dannyandreev/BOM-Lights/Guide/Step 1.png

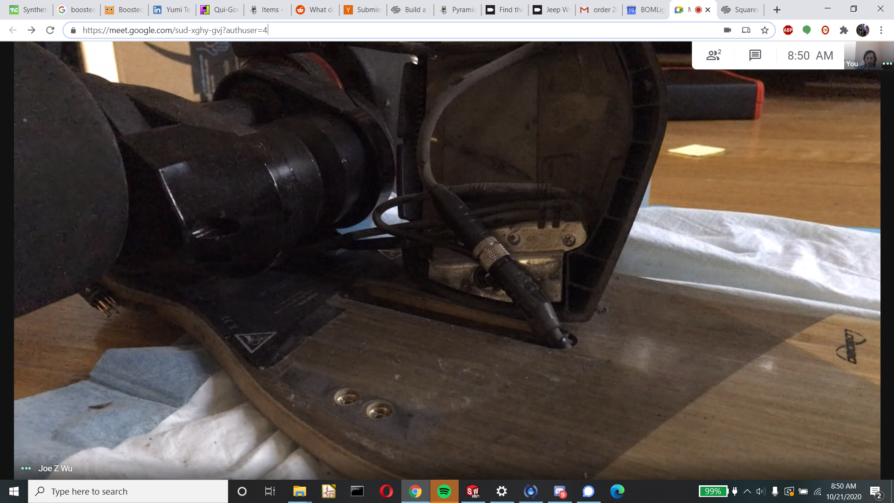
Guide/Step 1.png
