dannyandreev/BOM-Lights/Guide/Step 2.png

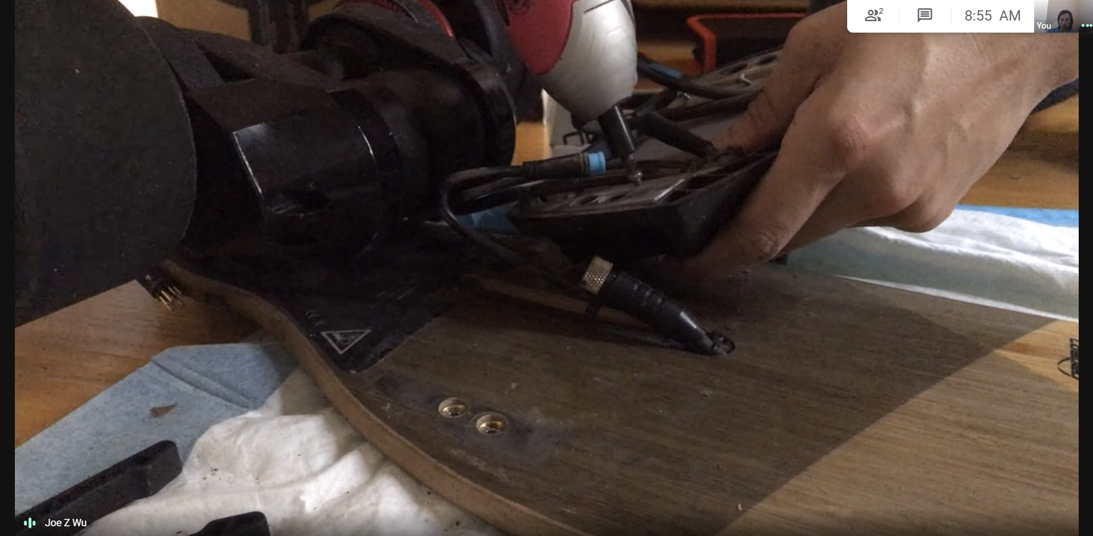
Guide/Step 2.png
