dannyandreev/BOM-Lights/Hardware/Packaging/BOX Text.jpg

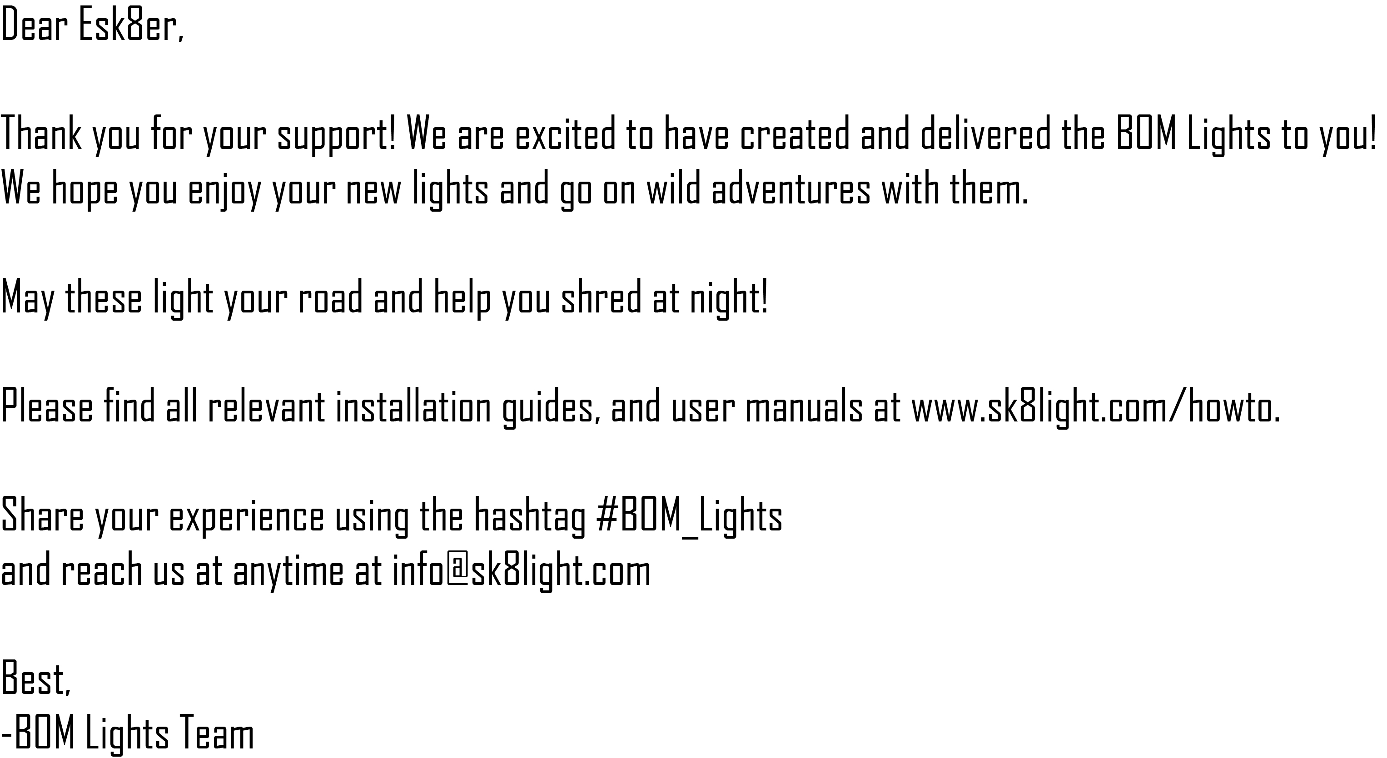
Hardware/Packaging/BOX Text.jpg
