dannyandreev/BOM-Lights/Electrical/SkateLightLEDBoard/SkateLightLEDBoard1.4/SkateLightLEDBoard1.4_BOM/SkateLightLEDBoard.csv

Id | Designator | Package | Quantity | Designation | Supplier and ref
1 | D3,D4,D5 | BXRE-40E0800-D-73 | 3 | LED
2 | J2,J1 | Conn_2x4_0.05in | 2 | Conn_02x04_Odd_Even
3 | H8,H7,H6,H5,H1,H2,H3,H4 | MH_0-80_Screw_Grounded | 8 | MountingHole_Pad
4 | U1,U2 | SOT-23 | 2 | MCP9700AT-E_TT
5 | D1 | D_0402_1005Metric | 1 | LEDR
6 | D2 | D_0402_1005Metric | 1 | LEDG
7 | Q1,Q2 | D_0603_1608Metric | 2 | Q_Photo_NPN
8 | R3,R4 | R_0402_1005Metric | 2 | 10k 1%
9 | R1 | R_0402_1005Metric | 1 | 2k7 5%
10 | R2 | R_0402_1005Metric | 1 | 390 5%
