dannyandreev/BOM-Lights/Electrical/SkateLightLEDBoard/SkateLightLEDBoard1.5/SkateLightLEDBoard1.5_BOM/SkateLightLEDBoard1.5_BOM.xls

Id | Designator | Package | Designation | Supplier and ref | Quantity
1 | D3,D4,D5 | BXRE-40E0800-D-73 | LED | BXRE-40E0800-D-73 (https://www.digikey.com/product-detail/en/BXRE-40E0800-D-73/976-1718-ND/7491539/?itemSeq=329745206) | 3
2 | J2,J1 | Conn_2x4_0.05in | Conn_02x04_Odd_Even | 20021111-00008T4LF (https://www.digikey.com/product-detail/en/amphenol-icc-fci/20021111-00008T4LF/609-3711-ND/2209071) | 2
3 | H8,H7,H6,H5,H1,H2,H3,H4 | MH_0-80_Screw_Grounded | MountingHole_Pad | Not Populated | 0
4 | U1,U2 | SOT-23 | MCP9700AT-E_TT | MCP9700AT-E/TT (https://www.digikey.com/product-detail/en/microchip-technology/MCP9700AT-E-TT/MCP9700AT-E-TTCT-ND/3622388) | 2
5 | D1 | D_0402_1005Metric | LEDR | QBLP595-R (https://www.digikey.com/product-detail/en/qt-brightek-qtb/QBLP595-R/1516-1217-1-ND/6201914) | 1
6 | D2 | D_0402_1005Metric | LEDG | QBLP595-IG (https://www.digikey.com/product-detail/en/qt-brightek-qtb/QBLP595-IG/1516-1216-1-ND/6201913) | 1
7 | Q1,Q2 | D_0603_1608Metric | Q_Photo_NPN | PT19-21B/L41/TR8 (https://www.digikey.com/product-detail/en/everlight-electronics-co-ltd/PT19-21B-L41-TR8/1080-1383-1-ND/2676117) | 2
8 | R3,R4 | R_0402_1005Metric | 100k 1% | RMCF0402FT100K (https://www.digikey.com/product-detail/en/stackpole-electronics-inc/RMCF0402FT100K/RMCF0402FT100KCT-ND/1942928) | 2
9 | R1,R2 | R_0402_1005Metric | 2k7 5% | ERJ-2RKF2701X (https://www.digikey.com/product-detail/en/panasonic-electronic-components/ERJ-2RKF2701X/P2-70KLCT-ND/1746662) | 1
