dannyandreev/BOM-Lights/Electrical/SkateLightConnBoard/SkateLightConnBoard1.3/SkateLightConnBoard1.3_BOM/SkateLightConnBoard.csv

Id | Designator | Package | Designation | Supplier and ref | Quantity
1 | J3,J1 | Conn_2x4_0.05in | Conn_02x04_Odd_Even | 20021311-00008T4LF | 2
2 | J2 | Conn_2x8_0.05in | Conn_02x08_Odd_Even | 20021112-00016T4LF | 1
