dannyandreev/BOM-Lights/Hardware/SkateLightV3.7 7-11-20/SkatelightV3.7.SLDASM

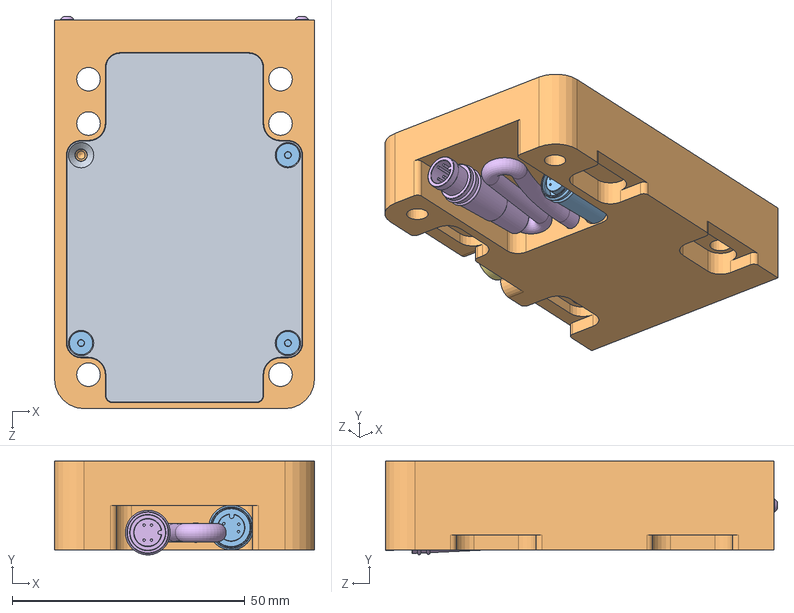
[picture p4: CAD file, 2022-03-13]
Hardware/SkateLightV3.7 7-11-20/SkatelightV3.7.SLDASM
55.9 x 20.1 x 84.3 mm
SkatelightBodyV5.8
SkateLightLEDBoard1.3
BXRE-40E0800-D-73 x 3
92949A050_18-8 SS BUTTON HEAD HEX DRIVE SCREW x 4
92949A054_18-8 SS BUTTON HEAD HEX DRIVE SCREW x 6
Header.05 Pitch Male 8Pin 2Row 2.54mm x 2
Header.05 Pitch Female 8Pin 2Row 20021311-00008T4LF x 4
Header.05 Pitch Male Right Angle 16Pin 2Row FTSH-108-01-L-D-RA x 2
SkatelightConnectorBoard1.2 x 2
92210A077_18-8 STAINLESS STEEL FLAT-HEAD SCKT CAP SCREW x 3
VSON-8_3.3x3.3mm_P0.65mm_NexFET x 2
MS-026ABA
LGA-14_3x2.5mm_P0.5mm_LayoutBorder3x4y
C1210_270
7447709151 Inductor
ETQ-P5M101YGC Inductor
92949A077_18-8 SS BUTTON HEAD HEX DRIVE SCREW x 2
SkatelightLidV5.7
SkatelightLEDCapV5.1
Lid gasket
LED gasket
Julet Gen 1 4 Pin M TailCustom
Acouto 1A 24V 8mm Mini Switch
Julet Gen 1 4 Pin F TailCustom
PiezoBuzzer
