dannyandreev/BOM-Lights/Hardware/V3/SkateLightLEDBackPanelAssembly.SLDASM

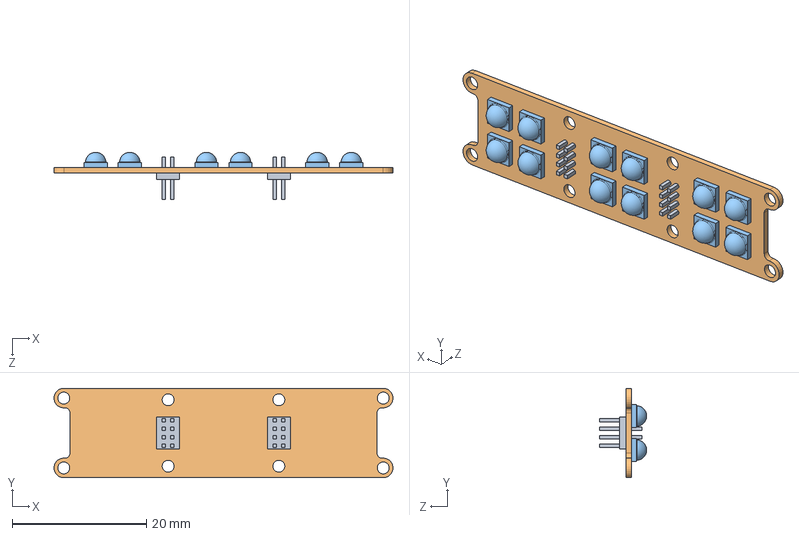
[picture p5: CAD file, 2022-03-13]
Hardware/V3/SkateLightLEDBackPanelAssembly.SLDASM
50.5 x 13.3 x 7.06 mm
Header.05 Pitch Male 8Pin 2Row 1mm HPH2-A-08-UA x 2
LEDBackPanel
XLampXPE2 x 12
