dannyandreev/BOM-Lights/Hardware/SkateLightV3.7 7-11-20/SkateLightMainBoard3.2.SLDASM

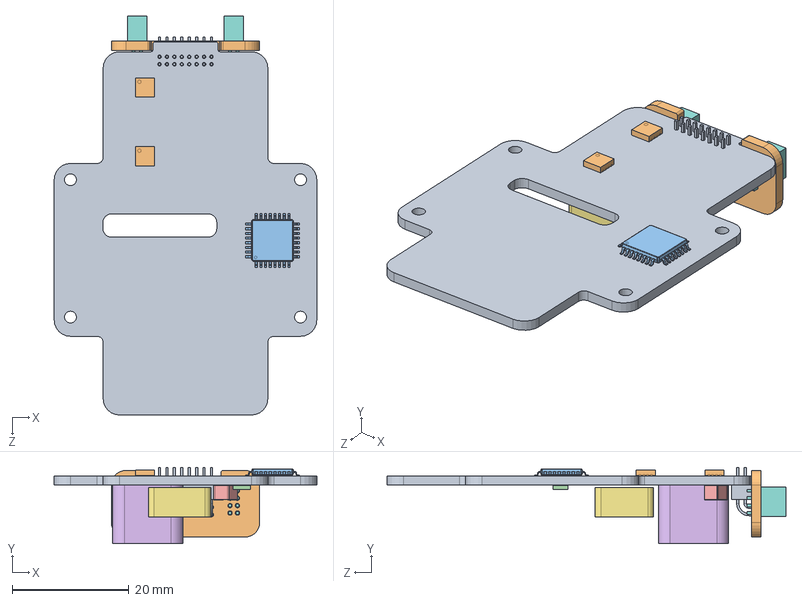
[picture p6: CAD file, 2022-03-13]
Hardware/SkateLightV3.7 7-11-20/SkateLightMainBoard3.2.SLDASM
45.0 x 13.0 x 68.3 mm
SkatelightMainBoard3.2
VSON-8_3.3x3.3mm_P0.65mm_NexFET x 2
MS-026ABA
LGA-14_3x2.5mm_P0.5mm_LayoutBorder3x4y
C1210_270
7447709151 Inductor
ETQ-P5M101YGC Inductor
Header.05 Pitch Female 8Pin 2Row 20021311-00008T4LF x 2
Header.05 Pitch Male Right Angle 16Pin 2Row FTSH-108-01-L-D-RA
SkatelightConnectorBoard1.2
