dannyandreev/BOM-Lights/Hardware/Packaging/PackageWithBox.SLDASM

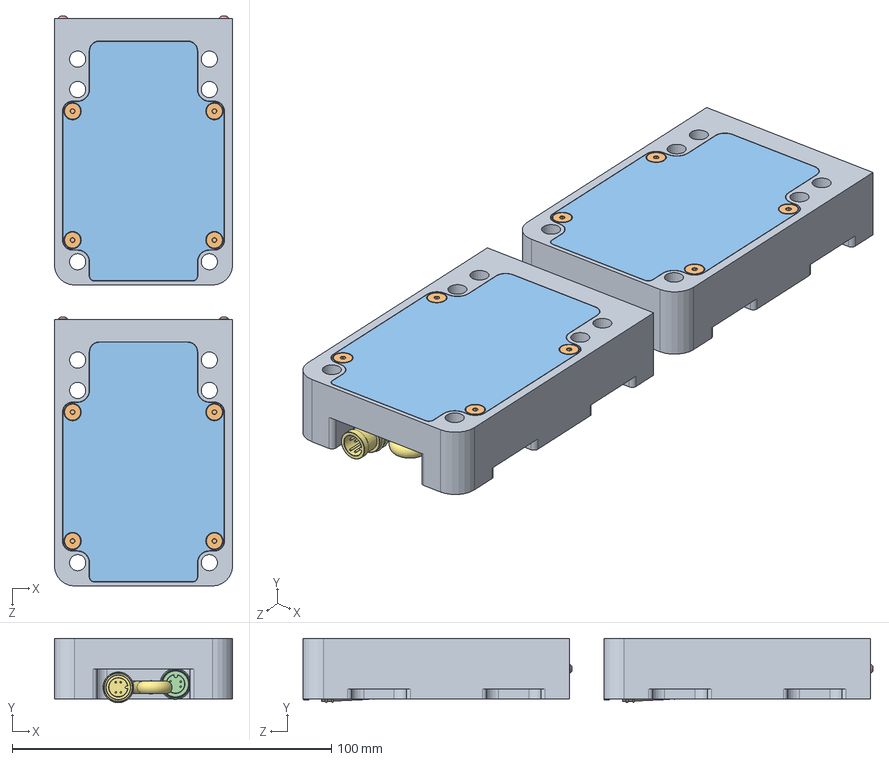
[picture p7: CAD file, 2022-03-13]
Hardware/Packaging/PackageWithBox.SLDASM
55.9 x 20.1 x 178.6 mm
SkatelightBodyV5.8 x 2
SkateLightLEDBoard1.3 x 2
BXRE-40E0800-D-73 x 6
92949A050_18-8 SS BUTTON HEAD HEX DRIVE SCREW x 8
92949A054_18-8 SS BUTTON HEAD HEX DRIVE SCREW x 12
Header.05 Pitch Male 8Pin 2Row 2.54mm x 4
Header.05 Pitch Female 8Pin 2Row 20021311-00008T4LF x 8
Header.05 Pitch Male Right Angle 16Pin 2Row FTSH-108-01-L-D-RA x 4
SkatelightConnectorBoard1.2 x 4
92210A077_18-8 STAINLESS STEEL FLAT-HEAD SCKT CAP SCREW x 8
SkatelightMainBoard3.2 x 2
VSON-8_3.3x3.3mm_P0.65mm_NexFET x 4
MS-026ABA x 2
LGA-14_3x2.5mm_P0.5mm_LayoutBorder3x4y x 2
C1210_270 x 2
7447709151 Inductor x 2
ETQ-P5M101YGC Inductor x 2
92949A077_18-8 SS BUTTON HEAD HEX DRIVE SCREW x 8
SkatelightLidV5.7 x 2
SkatelightLEDCapV5.1 x 2
Lid gasket x 2
LED gasket x 2
Julet Gen 1 4 Pin M TailCustom x 2
Acouto 1A 24V 8mm Mini Switch x 2
Julet Gen 1 4 Pin F TailCustom x 2
PiezoBuzzer x 2
