dannyandreev/BOM-Lights/Hardware/SkateLightV3.6 6-10-20/LEDPanelAssembly.SLDASM

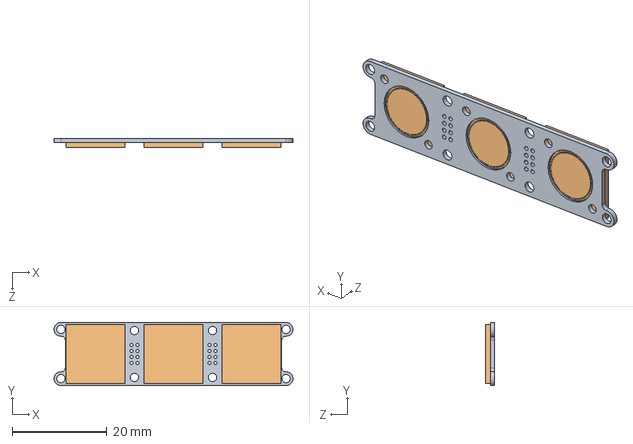
[picture p8: CAD file, 2022-03-13]
Hardware/SkateLightV3.6 6-10-20/LEDPanelAssembly.SLDASM
50.5 x 13.3 x 1.80 mm
SkateLightLEDBoard1.3
BXRE-40E0800-D-73 x 3
