dannyandreev/BOM-Lights/Hardware/SkateLightV3.6 6-10-20/ConnAssembly.SLDASM

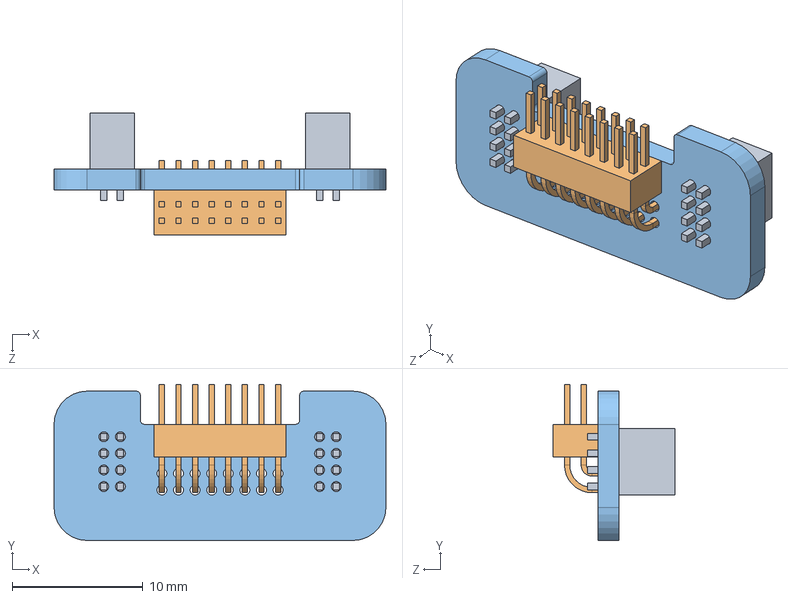
[picture p9: CAD file, 2022-03-13]
Hardware/SkateLightV3.6 6-10-20/ConnAssembly.SLDASM
25.4 x 11.9 x 9.33 mm
Header.05 Pitch Female 8Pin 2Row 20021311-00008T4LF x 2
Header.05 Pitch Male Right Angle 16Pin 2Row FTSH-108-01-L-D-RA
SkatelightConnectorBoard1.2
