dannyandreev/BOM-Lights/Hardware/SkateLightV3.6 6-10-20/SkateLightMainBoard3.1.SLDASM

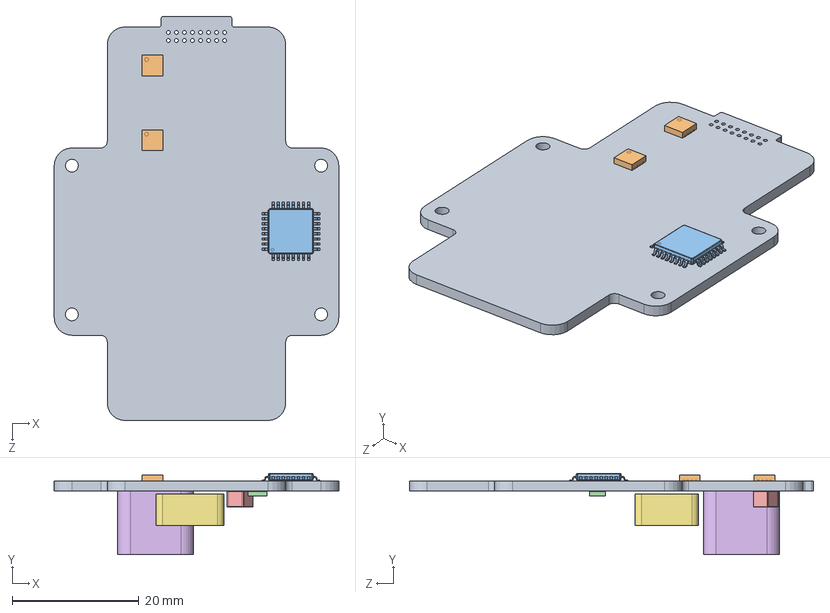
[picture p10: CAD file, 2022-03-13]
Hardware/SkateLightV3.6 6-10-20/SkateLightMainBoard3.1.SLDASM
45.0 x 12.8 x 63.8 mm
SkatelightMainBoard3.2
VSON-8_3.3x3.3mm_P0.65mm_NexFET x 2
MS-026ABA
LGA-14_3x2.5mm_P0.5mm_LayoutBorder3x4y
C1210_270
7447709151 Inductor
ETQ-P5M101YGC Inductor
