dannyandreev/BOM-Lights/Hardware/SkateLightV3.6 6-10-20/SkatelightV3.6.SLDASM

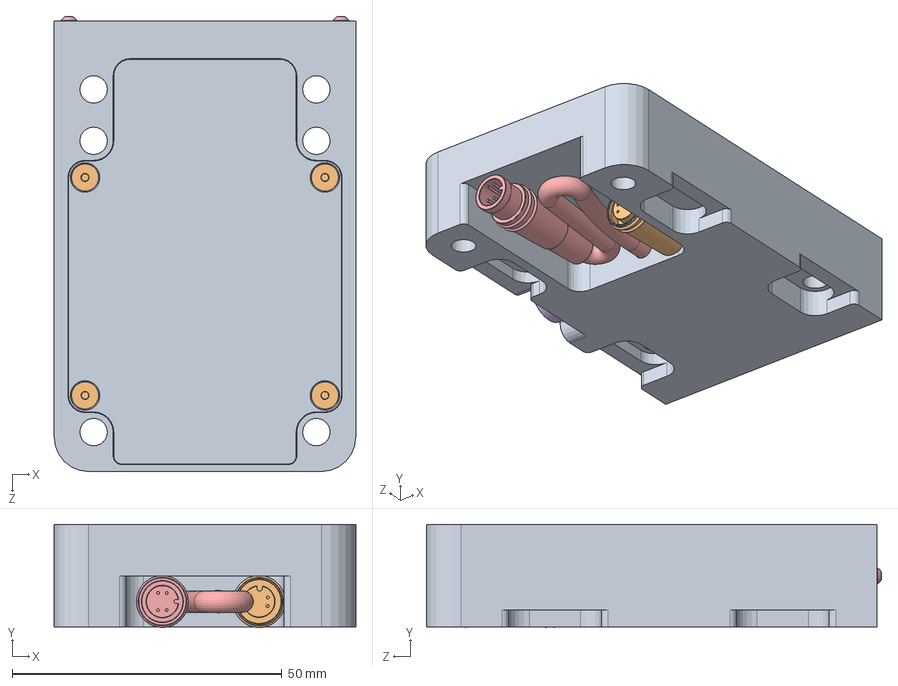
[picture p11: CAD file, 2022-03-13]
Hardware/SkateLightV3.6 6-10-20/SkatelightV3.6.SLDASM
55.9 x 19.1 x 84.3 mm
SkatelightBodyV5.8
SkateLightLEDBoard1.3
BXRE-40E0800-D-73 x 3
92949A050_18-8 SS BUTTON HEAD HEX DRIVE SCREW x 4
92949A054_18-8 SS BUTTON HEAD HEX DRIVE SCREW x 6
Header.05 Pitch Male 8Pin 2Row 2.54mm x 2
Header.05 Pitch Female 8Pin 2Row 20021311-00008T4LF x 2
Header.05 Pitch Male Right Angle 16Pin 2Row FTSH-108-01-L-D-RA
SkatelightConnectorBoard1.2
92210A077_18-8 STAINLESS STEEL FLAT-HEAD SCKT CAP SCREW x 4
VSON-8_3.3x3.3mm_P0.65mm_NexFET x 2
MS-026ABA
LGA-14_3x2.5mm_P0.5mm_LayoutBorder3x4y
C1210_270
ETQ-P5M101YGC Inductor
92949A077_18-8 SS BUTTON HEAD HEX DRIVE SCREW x 4
SkatelightLidV5.7
SkatelightLEDCapV5
Lid gasket
LED gasket
Julet Gen 1 4 Pin M TailCustom
Acouto 1A 24V 8mm Mini Switch
Julet Gen 1 4 Pin F TailCustom
