dannyandreev/BOM-Lights/Hardware/Compatability/Boosted Truck Black.SLDPRT

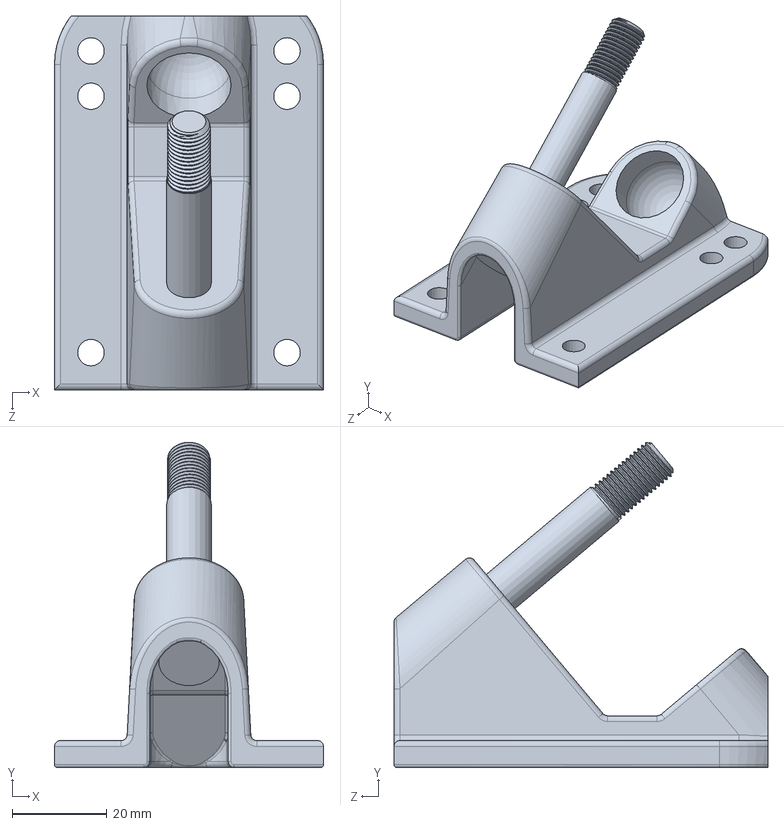
[picture p12: CAD file, 2022-03-13]
Hardware/Compatability/Boosted Truck Black.SLDPRT
56.6 x 68.5 x 78.7 mm
