dannyandreev/BOM-Lights/Hardware/Packaging/FoamInsert.SLDPRT

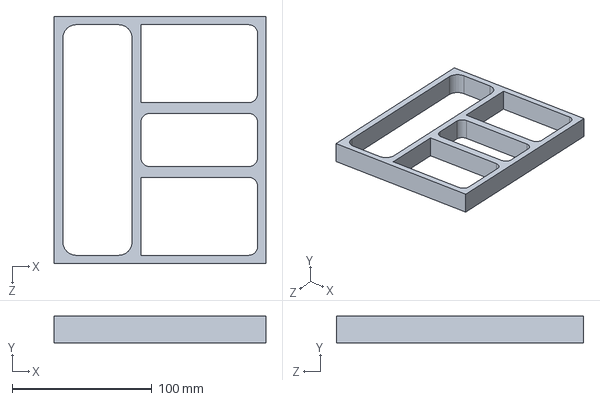
[picture p13: CAD file, 2022-03-13]
Hardware/Packaging/FoamInsert.SLDPRT
151.8 x 19.0 x 177.2 mm
