dannyandreev/BOM-Lights/Hardware/SkateLightV3.6 6-10-20/Lid gasket.SLDPRT

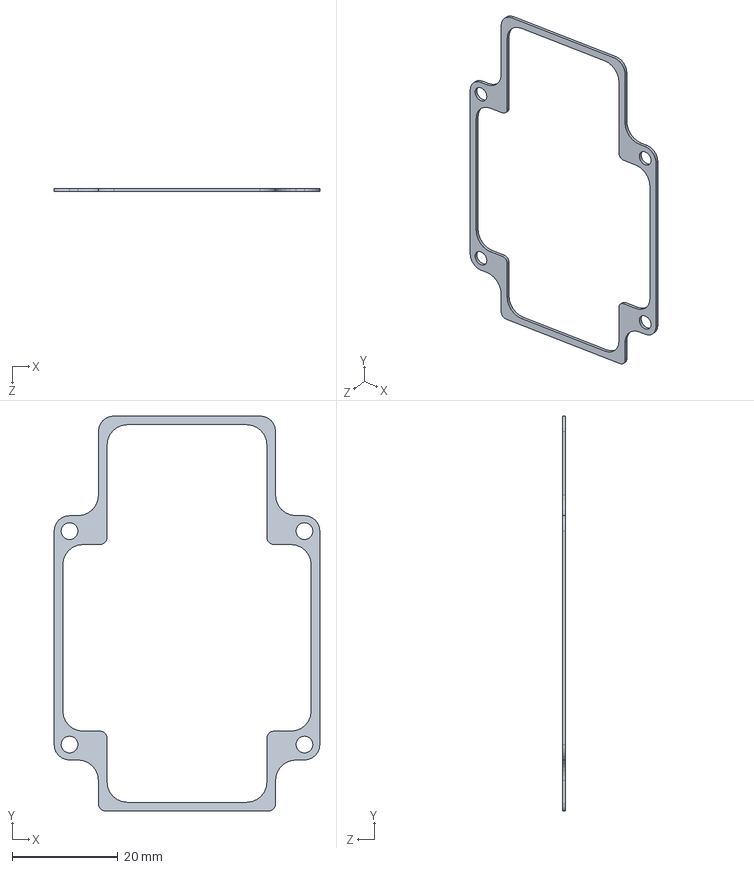
[picture p14: CAD file, 2022-03-13]
Hardware/SkateLightV3.6 6-10-20/Lid gasket.SLDPRT
50.3 x 74.7 x 0.65 mm
