dannyandreev/BOM-Lights/Hardware/Compatability/BoostedDeck.SLDPRT

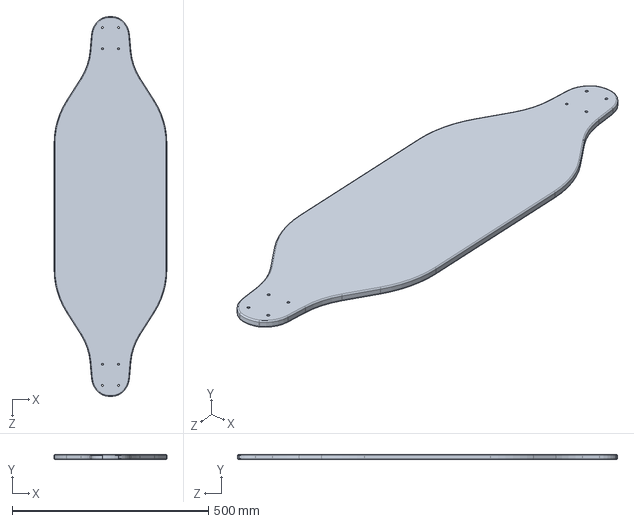
[picture p15: CAD file, 2022-03-13]
Hardware/Compatability/BoostedDeck.SLDPRT
287.0 x 12.7 x 967.5 mm
