dannyandreev/BOM-Lights/Hardware/Packaging/Box_1inx6inx7in.SLDPRT

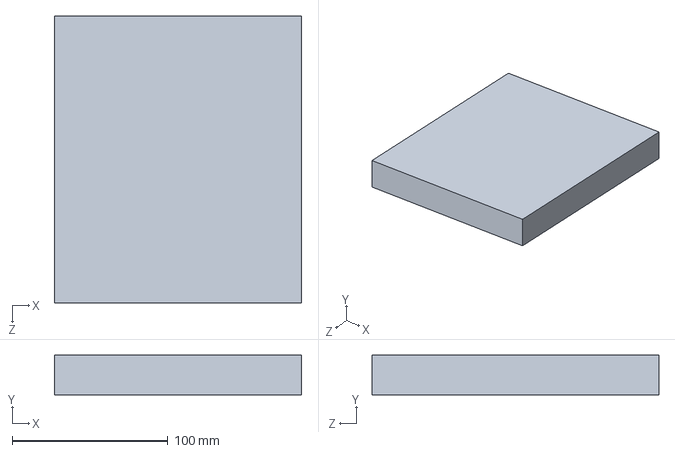
[picture p16: CAD file, 2022-03-13]
Hardware/Packaging/Box_1inx6inx7in.SLDPRT
158.8 x 25.4 x 184.1 mm
