dannyandreev/BOM-Lights/Hardware/SkateLightV3.6 6-10-20/SkatelightConnectorBoard1.2.SLDPRT

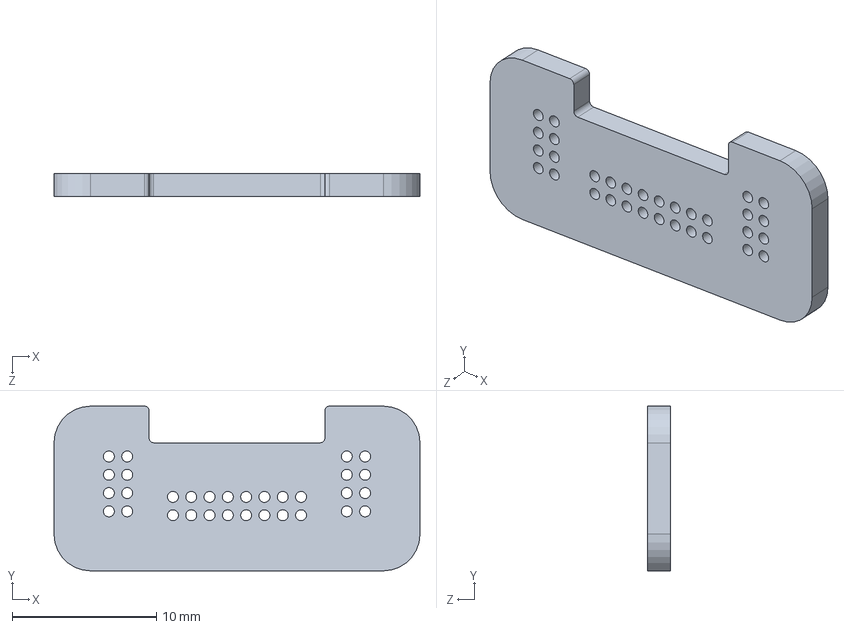
[picture p17: CAD file, 2022-03-13]
Hardware/SkateLightV3.6 6-10-20/SkatelightConnectorBoard1.2.SLDPRT
25.4 x 11.4 x 1.60 mm
