dannyandreev/BOM-Lights/Hardware/V3/SkateLightLEDBoard1.3.SLDPRT

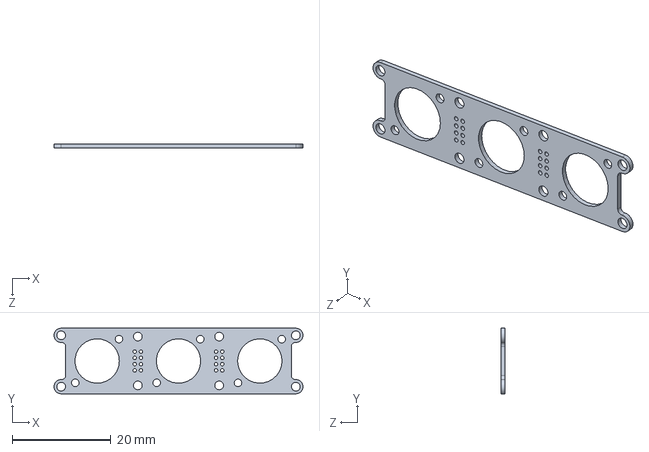
[picture p18: CAD file, 2022-03-13]
Hardware/V3/SkateLightLEDBoard1.3.SLDPRT
50.5 x 13.3 x 0.8 mm
