dannyandreev/BOM-Lights/Hardware/Compatability/Riser.SLDPRT

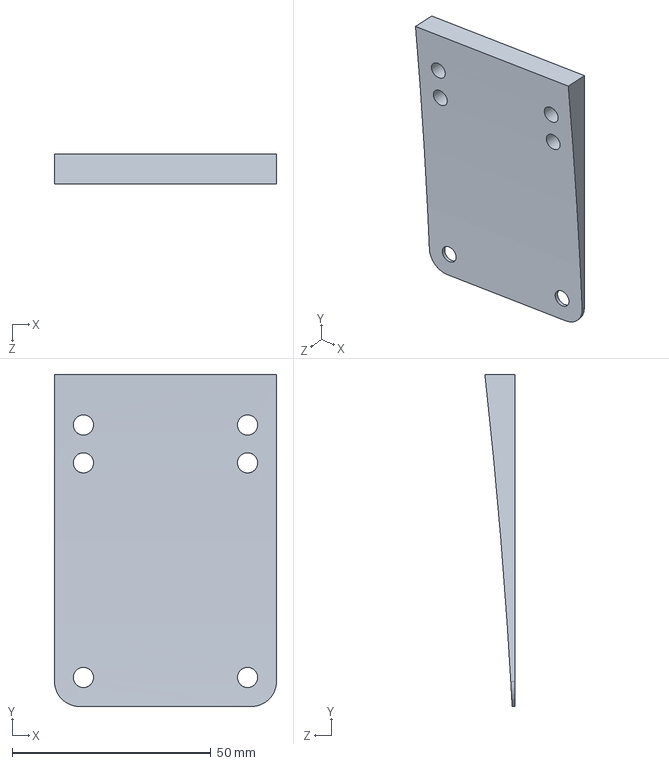
[picture p19: CAD file, 2022-03-13]
Hardware/Compatability/Riser.SLDPRT
55.9 x 83.5 x 7.62 mm
