dannyandreev/BOM-Lights/Hardware/SkateLightV3.7 7-11-20/SkatelightLEDCapV5.1.SLDPRT

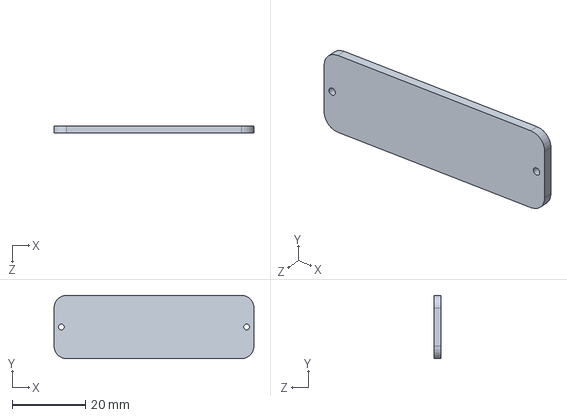
[picture p20: CAD file, 2022-03-13]
Hardware/SkateLightV3.7 7-11-20/SkatelightLEDCapV5.1.SLDPRT
54.5 x 17.3 x 2.00 mm
