dannyandreev/BOM-Lights/Hardware/V3/Header.05 Pitch Female 8Pin 2Row 20021311-00008T4LF.SLDPRT

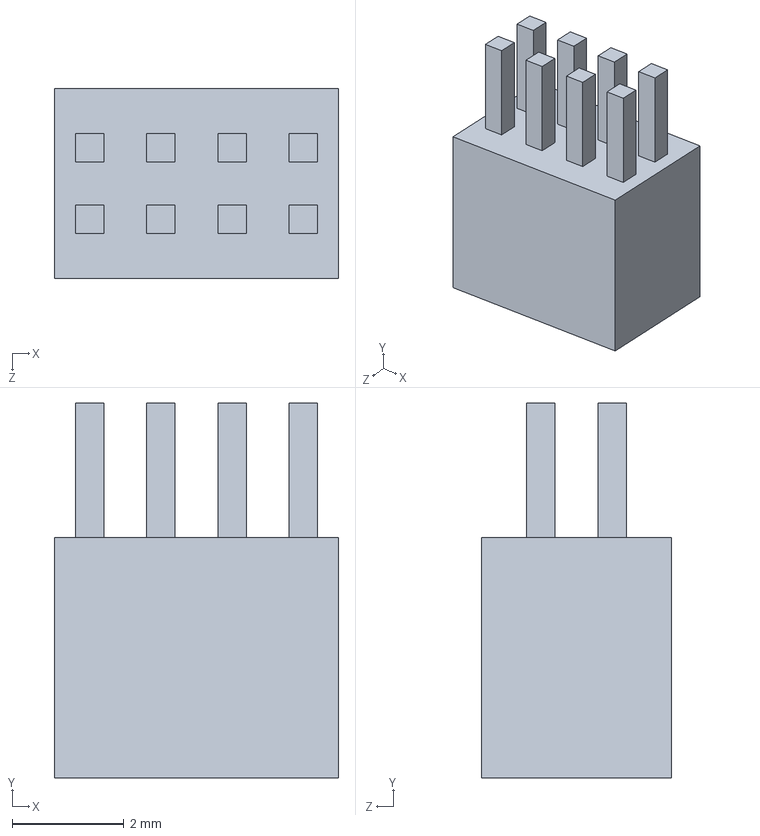
[picture p21: CAD file, 2022-03-13]
Hardware/V3/Header.05 Pitch Female 8Pin 2Row 20021311-00008T4LF.SLDPRT
5.08 x 6.70 x 3.40 mm
