dannyandreev/BOM-Lights/Hardware/Compatability/JL-F-Z910AT.SLDPRT

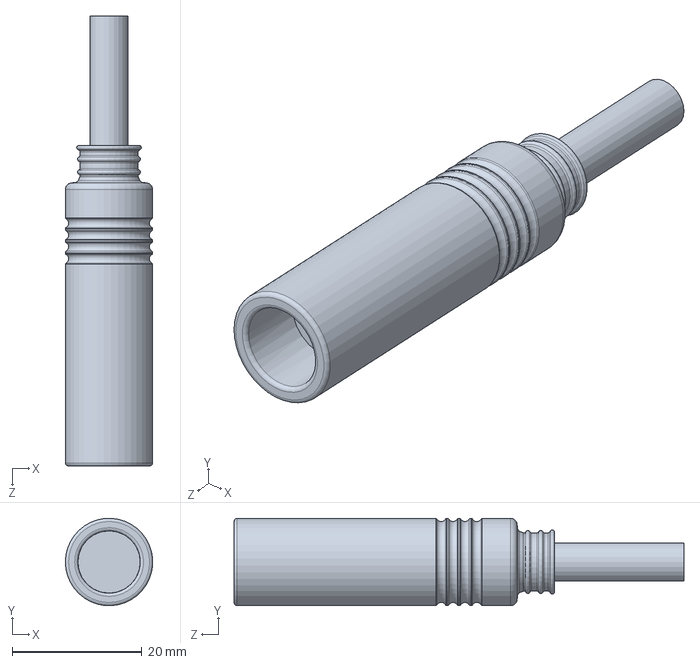
[picture p22: CAD file, 2022-03-13]
Hardware/Compatability/JL-F-Z910AT.SLDPRT
13.5 x 13.5 x 69.5 mm
