dannyandreev/BOM-Lights/Hardware/SkateLightV3.6 6-10-20/Julet Gen 1 4 Pin F TailCustom.SLDPRT

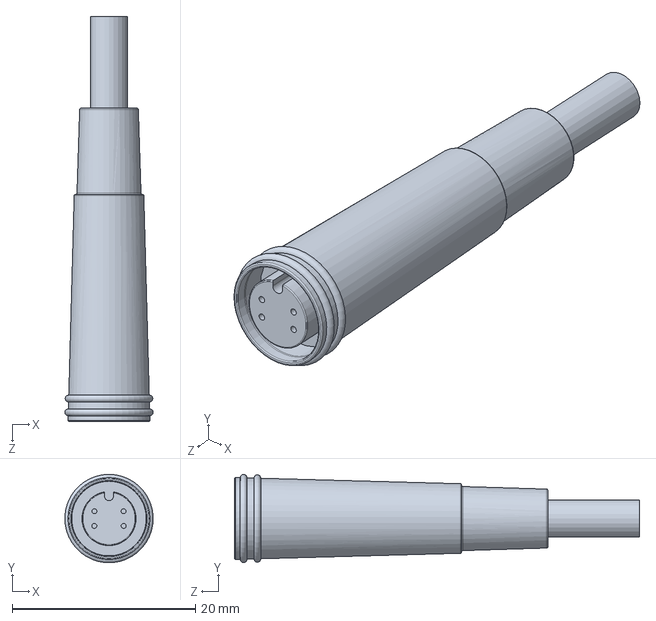
[picture p23: CAD file, 2022-03-13]
Hardware/SkateLightV3.6 6-10-20/Julet Gen 1 4 Pin F TailCustom.SLDPRT
9.65 x 9.64 x 44.2 mm
