dannyandreev/BOM-Lights/Hardware/SkateLightV3.7 7-11-20/SkatelightBodyV5.8.SLDPRT

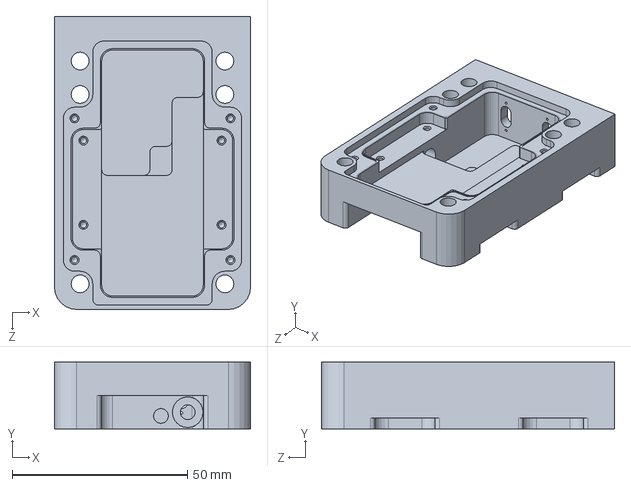
[picture p24: CAD file, 2022-03-13]
Hardware/SkateLightV3.7 7-11-20/SkatelightBodyV5.8.SLDPRT
55.9 x 19.1 x 83.5 mm
