dannyandreev/BOM-Lights/Hardware/V3/LEDBackPanel.SLDPRT

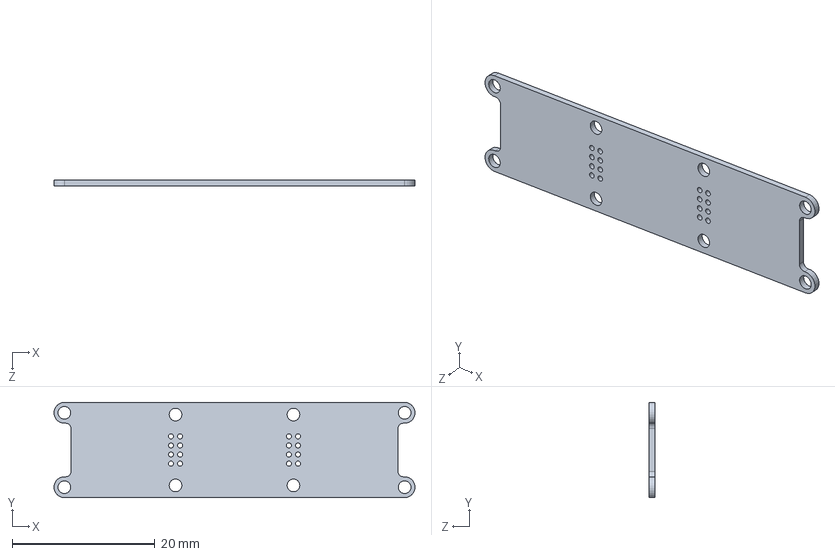
[picture p25: CAD file, 2022-03-13]
Hardware/V3/LEDBackPanel.SLDPRT
50.5 x 13.3 x 0.8 mm
