dannyandreev/BOM-Lights/Hardware/Compatability/BoostedPortWire.SLDPRT

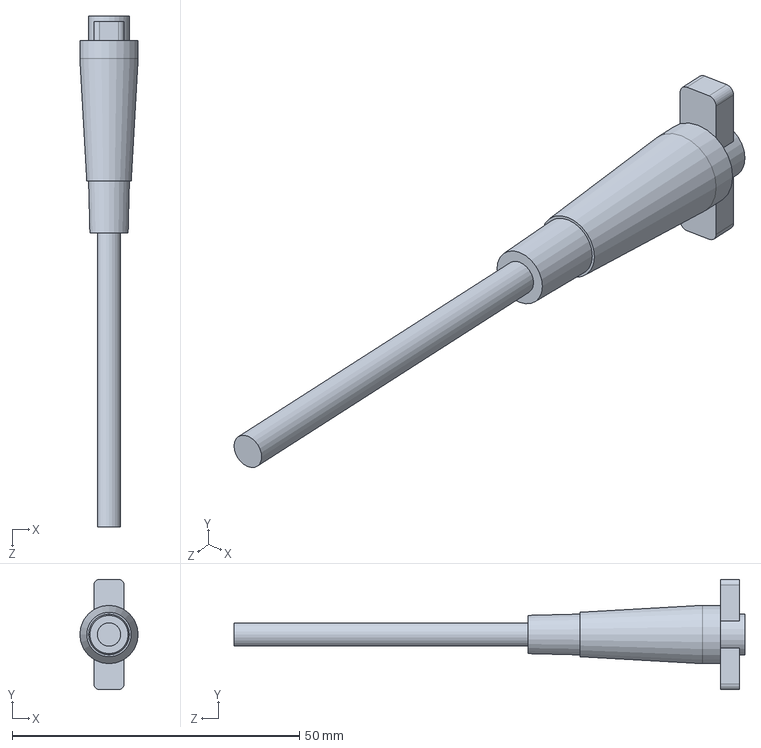
[picture p26: CAD file, 2022-03-13]
Hardware/Compatability/BoostedPortWire.SLDPRT
10.2 x 19.2 x 88.9 mm
