dannyandreev/BOM-Lights/Hardware/SkateLightV3.7 7-11-20/PiezoBuzzer.SLDPRT

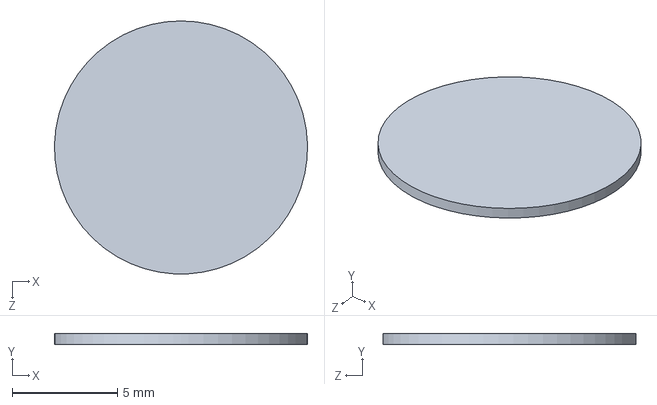
[picture p27: CAD file, 2022-03-13]
Hardware/SkateLightV3.7 7-11-20/PiezoBuzzer.SLDPRT
12.0 x 0.508 x 12.0 mm
