dannyandreev/BOM-Lights/Hardware/V3/Header.05 Pitch Male Right Angle 16Pin 2Row FTSH-108-01-L-D-RA.SLDPRT

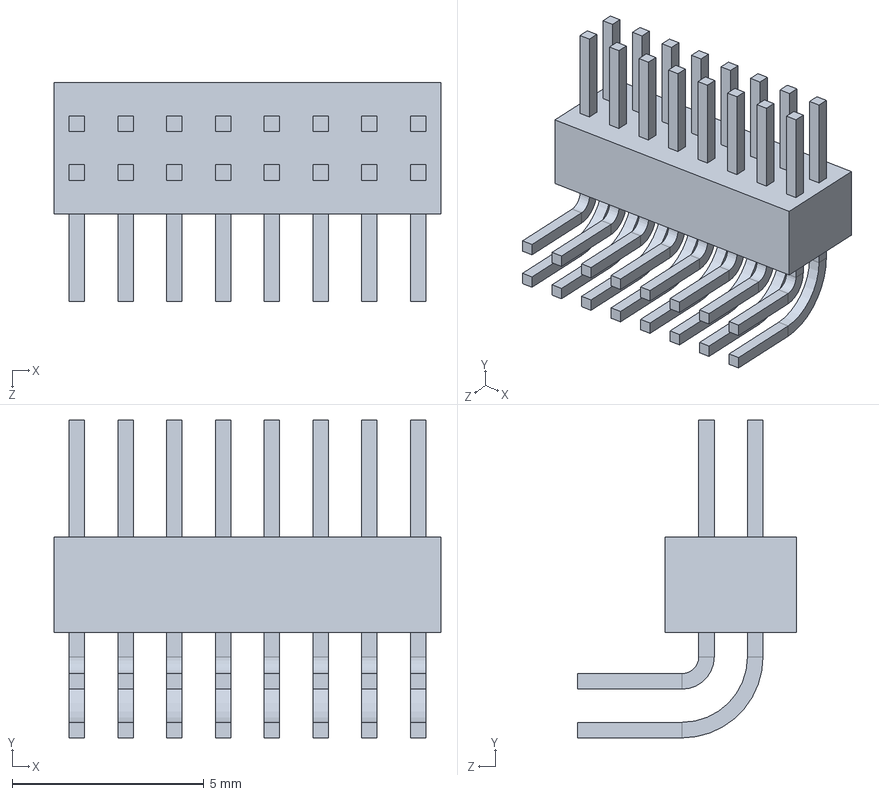
[picture p28: CAD file, 2022-03-13]
Hardware/V3/Header.05 Pitch Male Right Angle 16Pin 2Row FTSH-108-01-L-D-RA.SLDPRT
10.1 x 8.28 x 5.71 mm
