dannyandreev/BOM-Lights/Hardware/Compatability/MotorWireClipR.SLDPRT

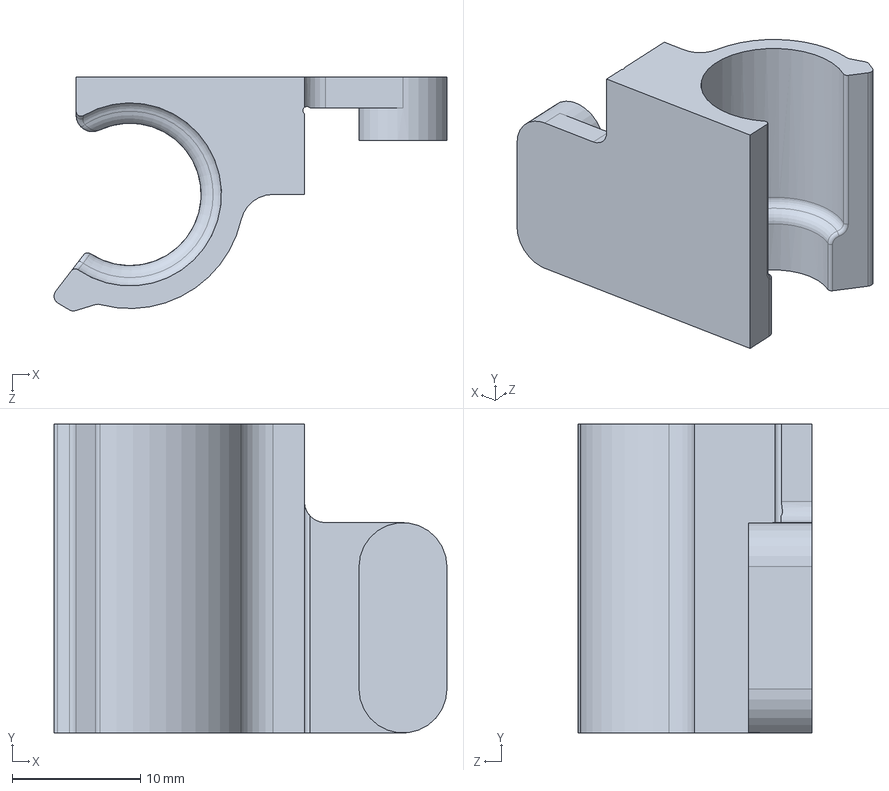
[picture p29: CAD file, 2022-03-13]
Hardware/Compatability/MotorWireClipR.SLDPRT
30.6 x 24.1 x 18.2 mm
