dannyandreev/BOM-Lights/Hardware/SkateLightV3.6 6-10-20/SkatelightLEDCapV5.SLDPRT

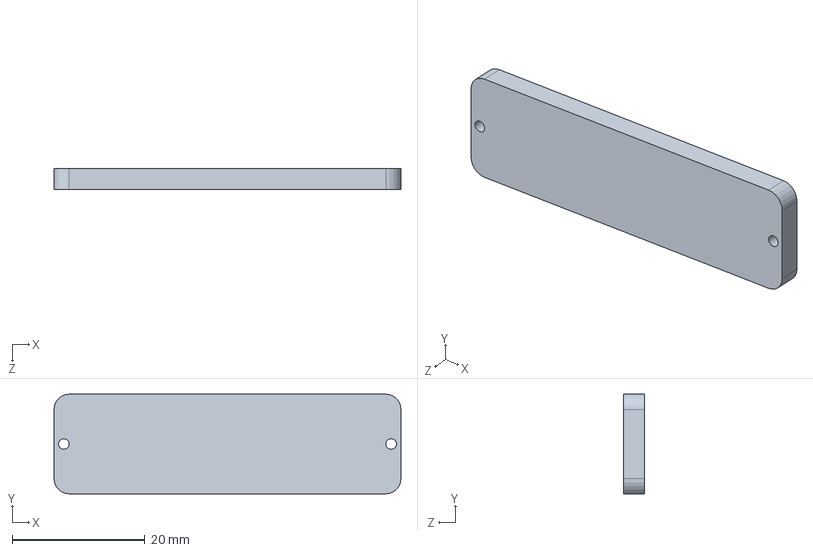
[picture p30: CAD file, 2022-03-13]
Hardware/SkateLightV3.6 6-10-20/SkatelightLEDCapV5.SLDPRT
52.2 x 15.0 x 3.18 mm
