dannyandreev/BOM-Lights/Hardware/SkateLightV3.6 6-10-20/SkatelightLidV5.7.SLDPRT

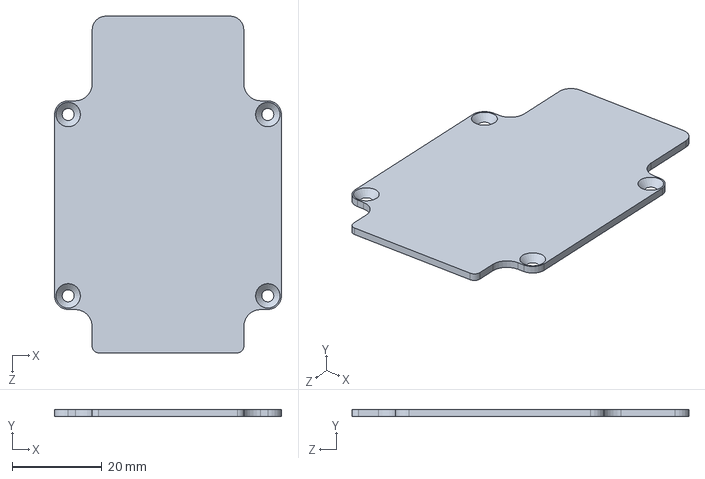
[picture p31: CAD file, 2022-03-13]
Hardware/SkateLightV3.6 6-10-20/SkatelightLidV5.7.SLDPRT
50.5 x 1.60 x 75.0 mm
