dannyandreev/BOM-Lights/Hardware/Compatability/JL-M-Z910AT.SLDPRT

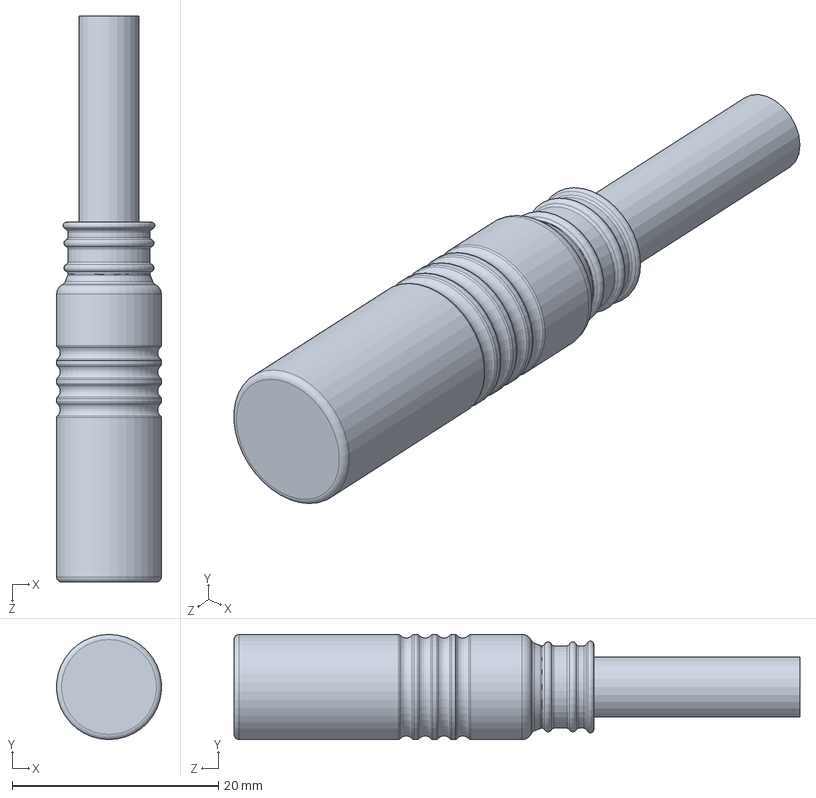
[picture p32: CAD file, 2022-03-13]
Hardware/Compatability/JL-M-Z910AT.SLDPRT
10.2 x 10.2 x 54.9 mm
