dannyandreev/BOM-Lights/Hardware/SkateLightV3.6 6-10-20/BumperV1.0.SLDPRT

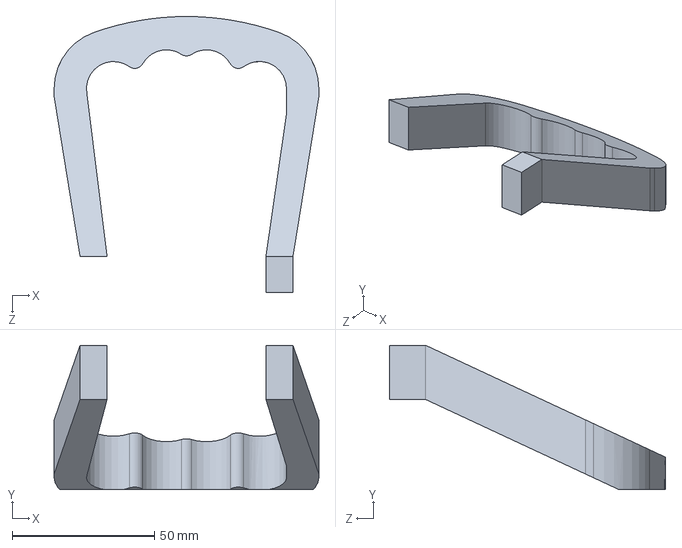
[picture p33: CAD file, 2022-03-13]
Hardware/SkateLightV3.6 6-10-20/BumperV1.0.SLDPRT
93.2 x 50.8 x 97.1 mm
