dannyandreev/BOM-Lights/Hardware/SkateLightV3.6 6-10-20/LED gasket.SLDPRT

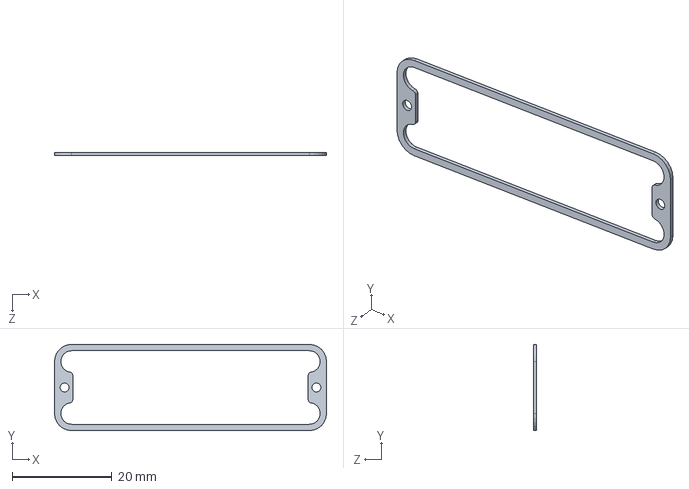
[picture p34: CAD file, 2022-03-13]
Hardware/SkateLightV3.6 6-10-20/LED gasket.SLDPRT
54.5 x 17.3 x 0.65 mm
