dannyandreev/BOM-Lights/Hardware/SkateLightV3.6 6-10-20/Julet Gen 1 4 Pin M TailCustom.SLDPRT

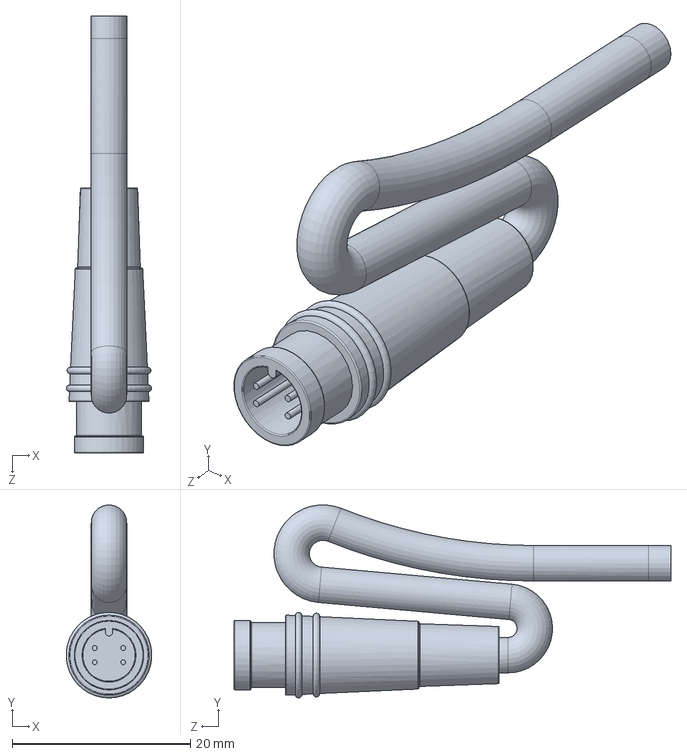
[picture p35: CAD file, 2022-03-13]
Hardware/SkateLightV3.6 6-10-20/Julet Gen 1 4 Pin M TailCustom.SLDPRT
9.58 x 21.7 x 49.0 mm
