dannyandreev/BOM-Lights/(list of files, cad)

Other CAD files:
Hardware/Compatability/MotorWireClip.SLDPRT
Hardware/Compatability/MotorWireClipL.SLDPRT
Hardware/Compatability/Riser.STL
Hardware/SkateLightV3.7 7-11-20/SkatelightMainBoard3.2.SLDPRT
