dannyandreev/BOM-Lights/Electrical/SkateLightLEDBoard/SkateLightLEDBoard1.4/ISSUES.txt

FIXES since last version
1) 
2) 
3) 
4) 

ISSUES with this version
1) 
2) 
3) 
4)
