dannyandreev/BOM-Lights/Electrical/SkateLightConnBoard/SkateLightConnBoard1.0/SkateLightConnBoard1.0.kicad_pcb

## KiCad design Electrical/SkateLightConnBoard/SkateLightConnBoard1.0/SkateLightConnBoard1.0.kicad_pcb (2022-03-13)

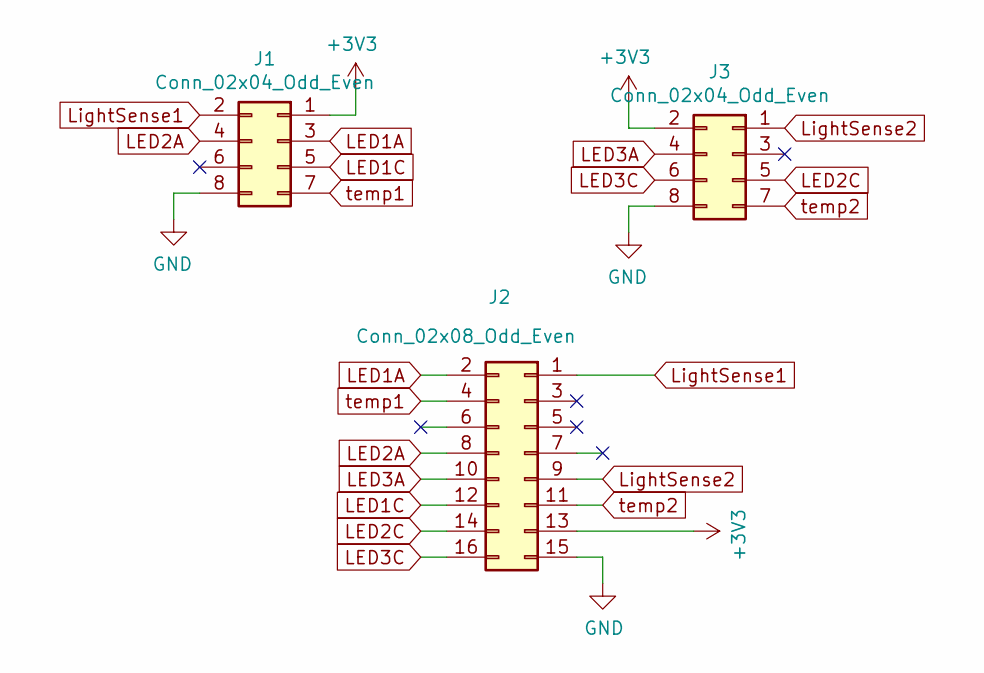
[picture p36: schematic SkateLightConnBoard1.0.sch]

Parts:
J1, J3: Conn_02x04_Odd_Even; Conn_2x4_0.05in
J2: Conn_02x08_Odd_Even; Conn_2x8_0.05in

Connections:
+3V3: J1.1, J2.13, J3.2
GND: J1.8, J2.15, J3.8
LED1A: J1.3, J2.2
LED1C: J1.5, J2.12
LED2A: J1.4, J2.8
LED2C: J2.14, J3.5
LED3A: J2.10, J3.4
LED3C: J2.16, J3.6
LightSense1: J1.2, J2.1
LightSense2: J2.9, J3.1
temp1: J1.7, J2.4
temp2: J2.11, J3.7

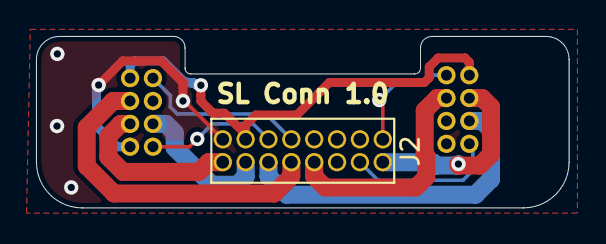
[picture p37: board SkateLightConnBoard1.0.kicad_pcb from above]

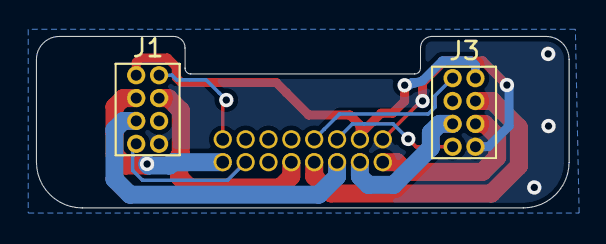
[picture p38: board SkateLightConnBoard1.0.kicad_pcb from below]

Board: 2 copper layers, 29.6 x 9.5 mm, 3 parts (2 on the bottom side), 12 nets.
