dannyandreev/BOM-Lights/Electrical/SkateLightLEDBoard/SkateLightLEDBoard1.3/SkateLightLEDBoard.kicad_pcb

## KiCad design Electrical/SkateLightLEDBoard/SkateLightLEDBoard1.3/SkateLightLEDBoard.kicad_pcb (2022-03-13)

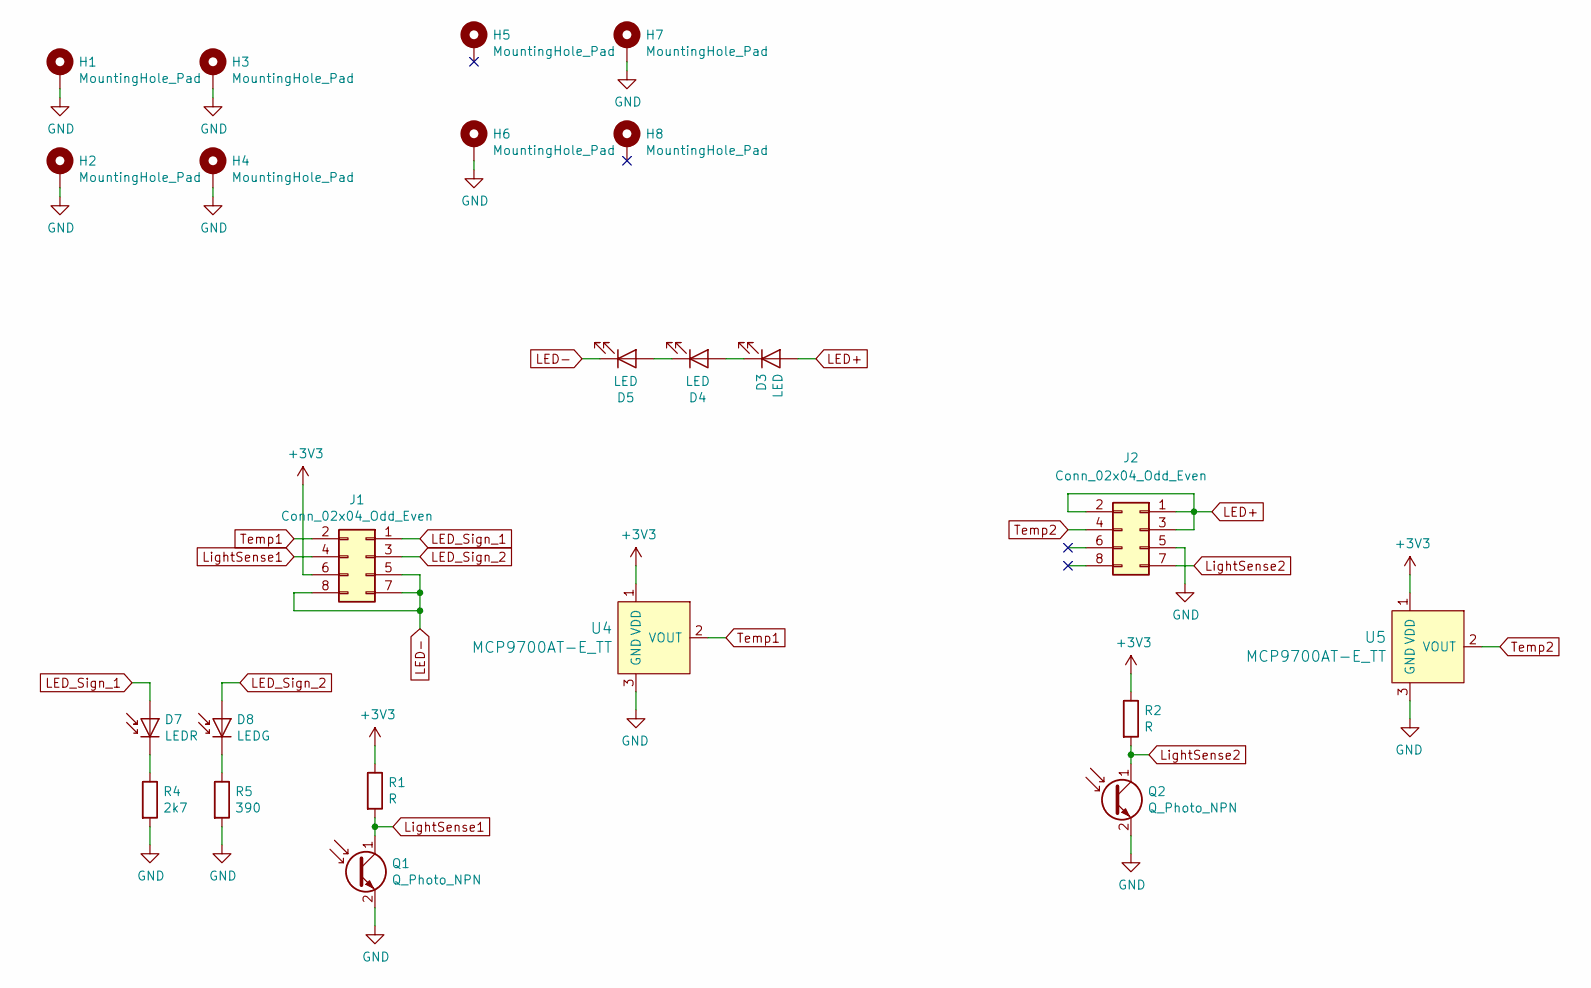
[picture p39: schematic SkateLightLEDBoard.sch]

Parts:
D3, D4, D5: LED; BXRE-40E0800-D-73
D7: LEDR; D_0402_1005Metric
D8: LEDG; D_0402_1005Metric
H1, H2, H3, H4, H5, H6, H7, H8: MountingHole_Pad; MH_0-80_Screw_Grounded
J1, J2: Conn_02x04_Odd_Even; Conn_2x4_0.05in
Q1, Q2: Q_Photo_NPN; D_0603_1608Metric
R1, R2: R; R_0402_1005Metric
R4: 2k7; R_0402_1005Metric
R5: 390; R_0402_1005Metric
U4, U5: MCP9700AT-E_TT; SOT-23; MPN MCP9700AT-E/TT; Digi-Key_PN MCP9700AT-E/TTCT-ND

Connections:
+3V3: J1.6, R1.1, R2.1, U4.1 (VDD), U5.1 (VDD)
GND: H1.1, H2.1, H3.1, H4.1, H6.1, H7.1, J2.5, Q1.2 (E), Q2.2 (E), R4.2, R5.2, U4.3 (GND), U5.3 (GND)
LED+: D3.2 (A), J2.1, J2.2, J2.3
LED-: D5.1 (K), J1.5, J1.7, J1.8
LED_Sign_1: D7.2 (A), J1.1
LED_Sign_2: D8.2 (A), J1.3
LightSense1: J1.4, Q1.1 (C), R1.2
LightSense2: J2.7, Q2.1 (C), R2.2
unnamed: D3.1 (K), D4.2 (A)
unnamed: D4.1 (K), D5.2 (A)
unnamed: D7.1 (K), R4.1
unnamed: D8.1 (K), R5.1
Temp1: J1.2, U4.2 (VOUT)
Temp2: J2.4, U5.2 (VOUT)

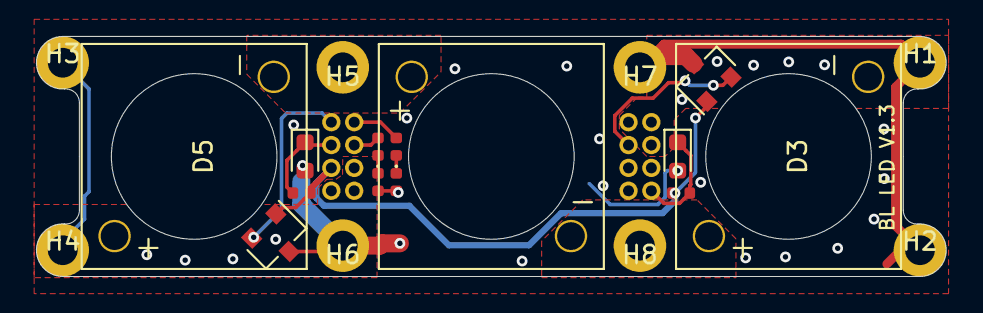
[picture p40: board Electrical/SkateLightLEDBoard/SkateLightLEDBoard1.3/SkateLightLEDBoar… from above]

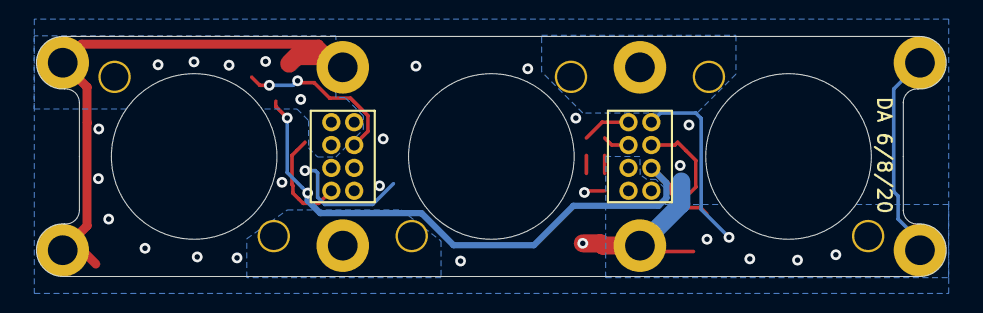
[picture p41: board Electrical/SkateLightLEDBoard/SkateLightLEDBoard1.3/SkateLightLEDBoar… from below]

Board: 2 copper layers, 50.5 x 13.3 mm, 23 parts (2 on the bottom side), 14 nets.
