dannyandreev/BOM-Lights/Electrical/SkateLightLEDBoard/SkateLightBackLEDBoard1.3/SkateLightBackLEDBoard.kicad_pcb

## KiCad design Electrical/SkateLightLEDBoard/SkateLightBackLEDBoard1.3/SkateLightBackLEDBoard.kicad_pcb (2022-03-13)

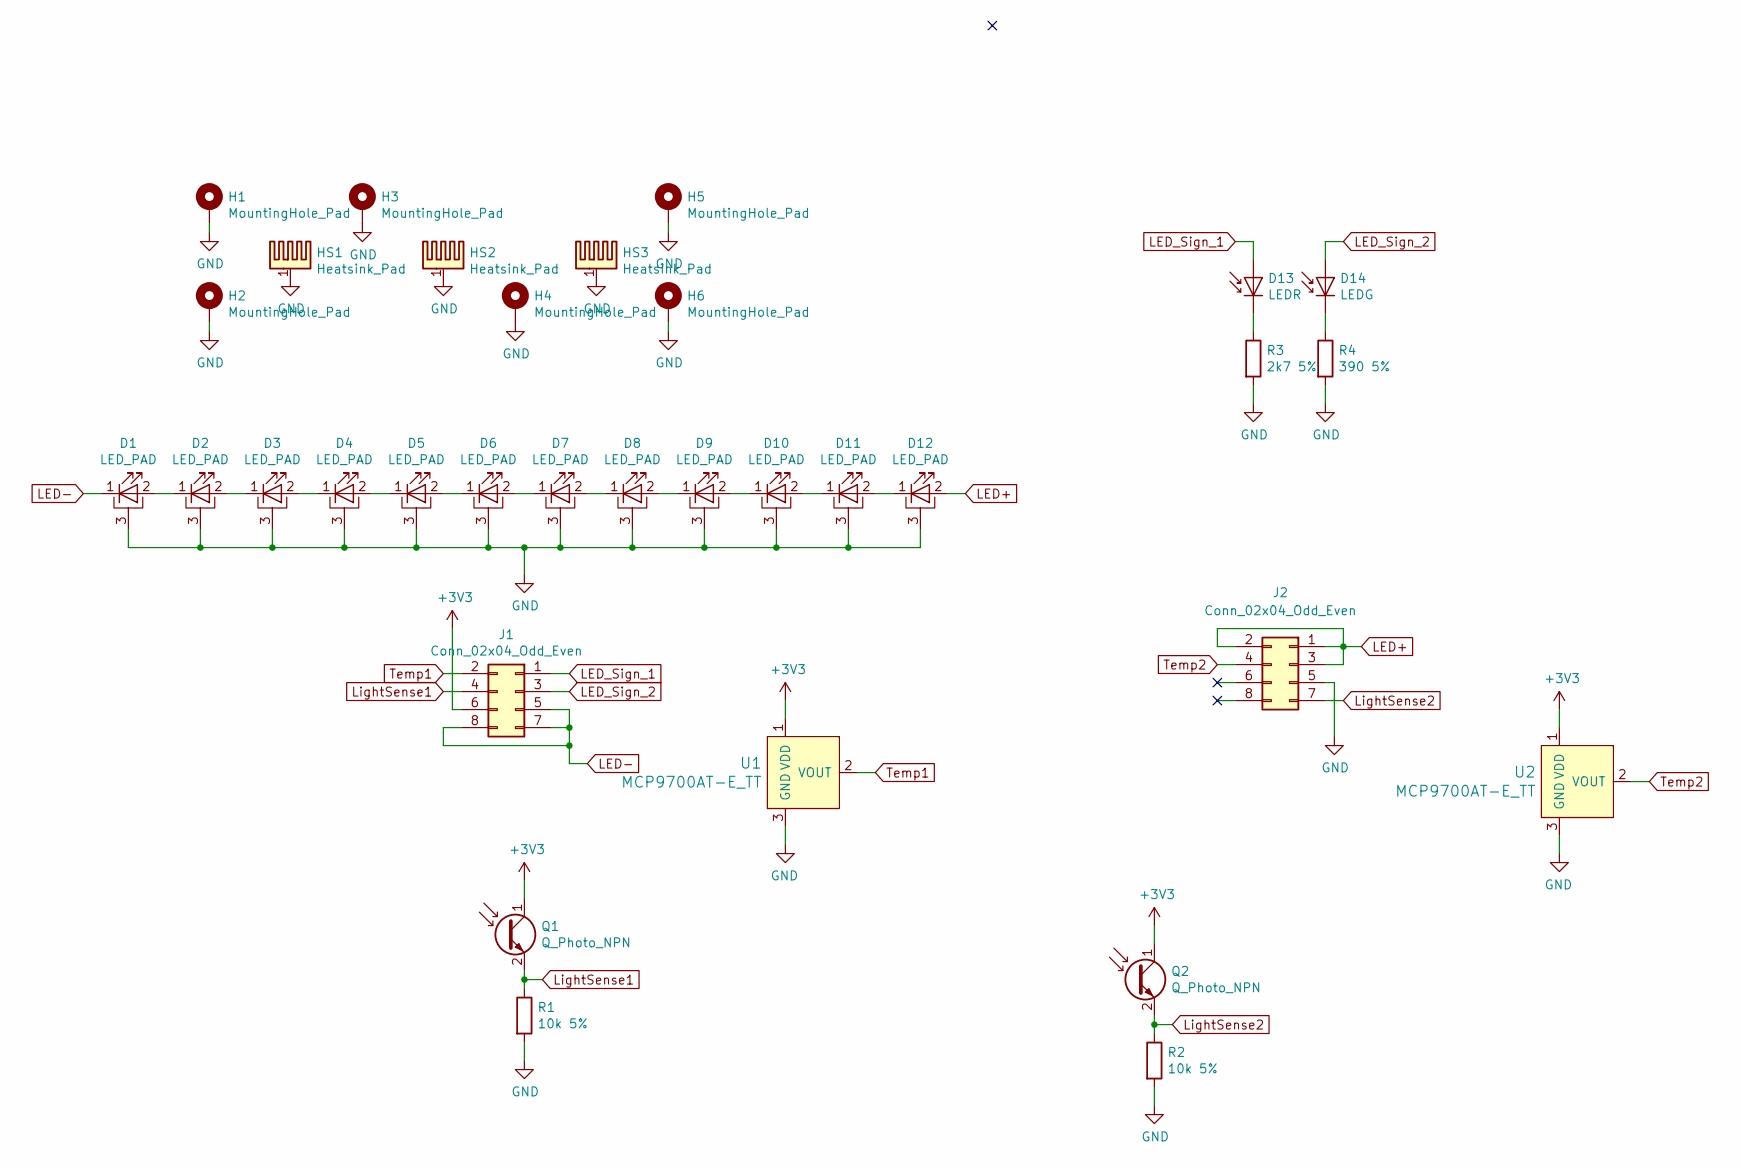
[picture p42: schematic SkateLightBackLEDBoard.sch]

Parts:
D1, D2, D3, D4, D5, D6, D7, D8, D9, D10, D11, D12: LED_PAD; SST-10-DR-B90-G660
D13: LEDR; D_0402_1005Metric
D14: LEDG; D_0402_1005Metric
H1, H2, H3, H4, H5, H6: MountingHole_Pad; MH_0-80_Screw_Grounded
HS1, HS2, HS3: Heatsink_Pad; BomLightBackLEDHeatsink
J1, J2: Conn_02x04_Odd_Even; Conn_2x4_0.05in
Q1, Q2: Q_Photo_NPN; D_0603_1608Metric
R1, R2: 10k 5%; R_0402_1005Metric
R3: 2k7 5%; R_0402_1005Metric
R4: 390 5%; R_0402_1005Metric
U1, U2: MCP9700AT-E_TT; SOT-23; MPN MCP9700AT-E/TT; Digi-Key_PN MCP9700AT-E/TTCT-ND

Connections:
+3V3: J1.6, Q1.1 (C), Q2.1 (C), U1.1 (VDD), U2.1 (VDD)
GND: D1.3 (PAD), D2.3 (PAD), D3.3 (PAD), D4.3 (PAD), D5.3 (PAD), D6.3 (PAD), D7.3 (PAD), D8.3 (PAD), D9.3 (PAD), D10.3 (PAD), D11.3 (PAD), D12.3 (PAD), H1.1, H2.1, H3.1, H4.1, H5.1, H6.1, HS1.1, HS2.1, HS3.1, J2.5, R1.2, R2.2, R3.2, R4.2, U1.3 (GND), U2.3 (GND)
LED+: D12.2 (A), J2.1, J2.2, J2.3
LED-: D1.1 (K), J1.5, J1.7, J1.8
LED_Sign_1: D13.2 (A), J1.1
LED_Sign_2: D14.2 (A), J1.3
LightSense1: J1.4, Q1.2 (E), R1.1
LightSense2: J2.7, Q2.2 (E), R2.1
unnamed: D1.2 (A), D2.1 (K)
unnamed: D2.2 (A), D3.1 (K)
unnamed: D3.2 (A), D4.1 (K)
unnamed: D4.2 (A), D5.1 (K)
unnamed: D5.2 (A), D6.1 (K)
unnamed: D6.2 (A), D7.1 (K)
unnamed: D7.2 (A), D8.1 (K)
unnamed: D8.2 (A), D9.1 (K)
unnamed: D9.2 (A), D10.1 (K)
unnamed: D10.2 (A), D11.1 (K)
unnamed: D11.2 (A), D12.1 (K)
unnamed: D13.1 (K), R3.1
unnamed: D14.1 (K), R4.1
Temp1: J1.2, U1.2 (VOUT)
Temp2: J2.4, U2.2 (VOUT)

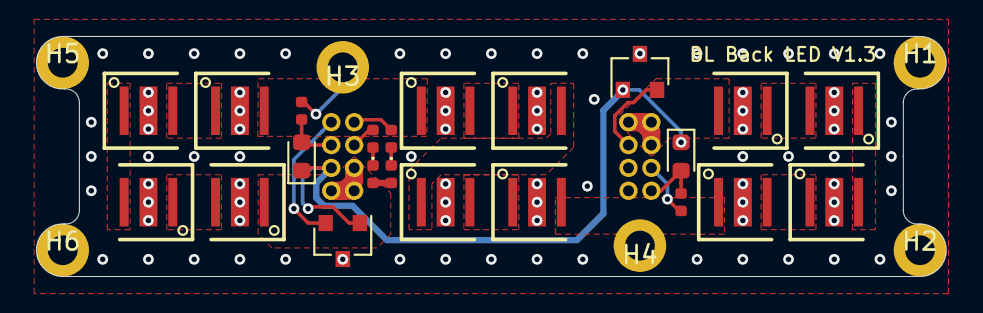
[picture p43: board Electrical/SkateLightLEDBoard/SkateLightBackLEDBoard1.3/SkateLightBac… from above]

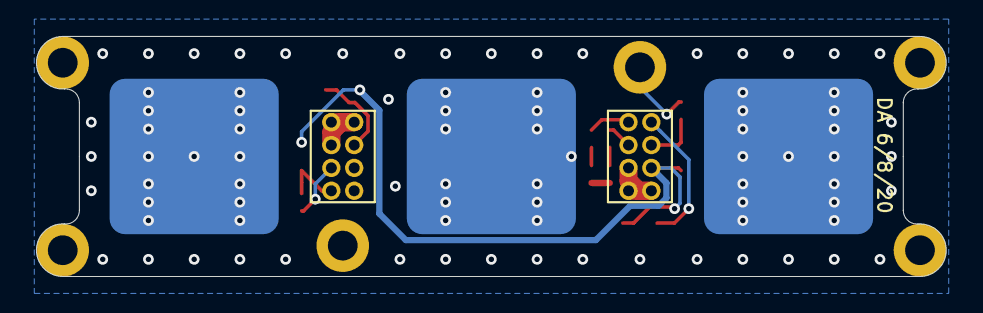
[picture p44: board Electrical/SkateLightLEDBoard/SkateLightBackLEDBoard1.3/SkateLightBac… from below]

Board: 2 copper layers, 50.5 x 13.3 mm, 33 parts (5 on the bottom side), 23 nets.
