dannyandreev/BOM-Lights/Electrical/SkateLightMainBoard/SkateLightMainBoard3.3/SkateLightMainBoard.kicad_pcb

## KiCad design Electrical/SkateLightMainBoard/SkateLightMainBoard3.3/SkateLightMainBoard.kicad_pcb (2022-03-13)

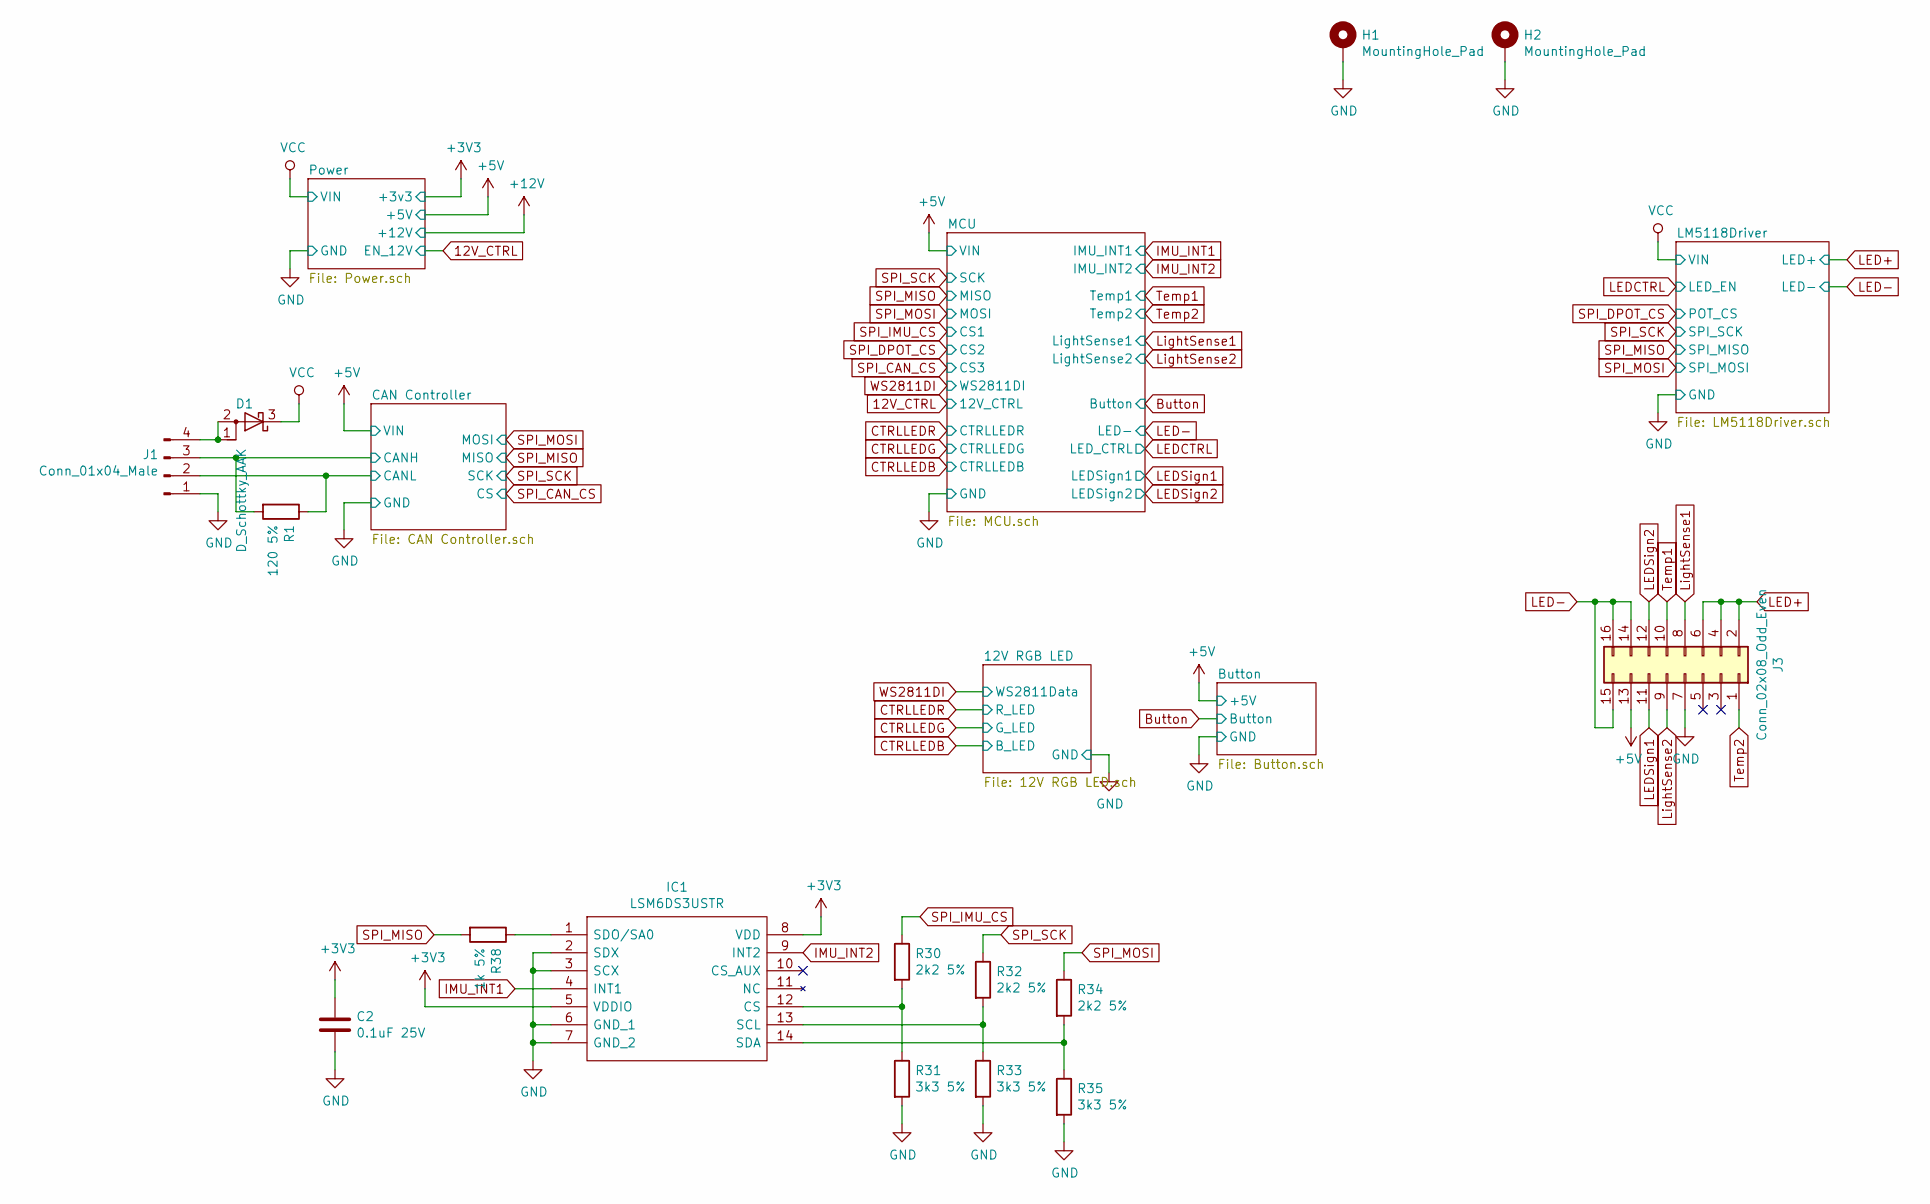
[picture p45: schematic SkateLightMainBoard.sch]

Parts:
C2: 0.1uF 25V; C_0805_2012Metric
D1: D_Schottky_AAK; TO-277A
H1: MountingHole_Pad; ThermalPadV2_SkateLight_L
H2: MountingHole_Pad; ThermalPadV2_SkateLight_R
IC1: LSM6DS3USTR; LGA-14(2.5X3X0.86); Manufacturer_Part_Number LSM6DS3USTR; Mouser Part Number 511-LSM6DS3USTR
J1: Conn_01x04_Male; 4 Wire Pad
J3: Conn_02x08_Odd_Even; Conn_2x8_0.05in
R1: 120 5%; R_0805_2012Metric
R30, R32, R34: 2k2 5%; R_0805_2012Metric
R31, R33, R35: 3k3 5%; R_0805_2012Metric
R38: 1k 5%; R_0805_2012Metric

Connections:
+3V3: C2.1, IC1.5 (VDDIO), IC1.8 (VDD); also elsewhere on the board
+5V: J3.13; also elsewhere on the board
/CAN Controller/CANH: J1.3, R1.2; also elsewhere on the board
/CAN Controller/CANL: J1.2, R1.1; also elsewhere on the board
GND: C2.2, H1.1, H2.1, IC1.2 (SDX), IC1.3 (SCX), IC1.6 (GND_1), IC1.7 (GND_2), J1.1, J3.7, R31.2, R33.2, R35.2; also elsewhere on the board
IMU_INT1: IC1.4 (INT1); also elsewhere on the board
IMU_INT2: IC1.9 (INT2); also elsewhere on the board
LED+: J3.2, J3.4, J3.6; also elsewhere on the board
LED-: J3.14, J3.15, J3.16; also elsewhere on the board
LEDSign1: J3.11; also elsewhere on the board
LEDSign2: J3.12; also elsewhere on the board
LightSense1: J3.8; also elsewhere on the board
LightSense2: J3.9; also elsewhere on the board
unnamed: D1.1 (A), D1.2 (A), J1.4
unnamed: IC1.1 (SDO/SA0), R38.1
unnamed: IC1.12 (CS), R30.2, R31.1
unnamed: IC1.13 (SCL), R32.2, R33.1
unnamed: IC1.14 (SDA), R34.2, R35.1
SPI_IMU_CS: R30.1; also elsewhere on the board
SPI_MISO: R38.2; also elsewhere on the board
SPI_MOSI: R34.1; also elsewhere on the board
SPI_SCK: R32.1; also elsewhere on the board
Temp1: J3.10; also elsewhere on the board
Temp2: J3.1; also elsewhere on the board
VCC: D1.3 (K); also elsewhere on the board

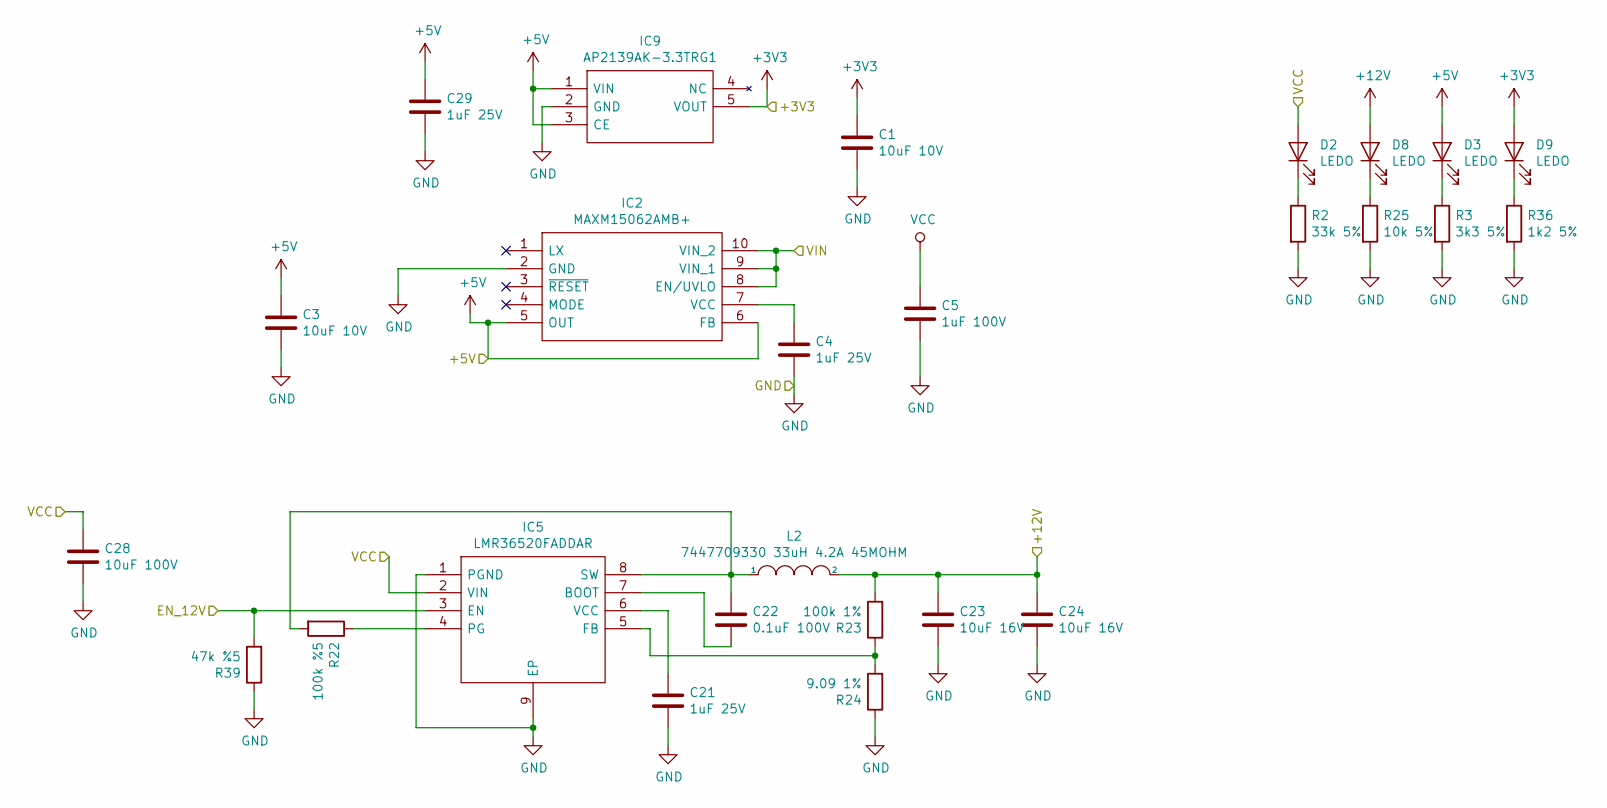
[picture p46: schematic Power.sch]

Parts:
C1, C3: 10uF 10V; C_0805_2012Metric
C4, C21, C29: 1uF 25V; C_0805_2012Metric
C5: 1uF 100V; C_0805_2012Metric
C22: 0.1uF 100V; C_0805_2012Metric
C23, C24: 10uF 16V; C_0805_2012Metric
C28: 10uF 100V; C_1210_3225Metric
D2, D3, D8, D9: LEDO; LED_0805_2012Metric
IC2: MAXM15062AMB+; MAXM15462AMB; Manufacturer_Part_Number MAXM15062AMB+; Mouser Part Number 700-MAXM15062AMB+
IC5: LMR36520FADDAR; SOIC127P600X170-9N; Manufacturer_Part_Number LMR36520FADDAR; Mouser Part Number 595-LMR36520FADDAR
IC9: AP2139AK-3.3TRG1; SOT-23-5; Manufacturer_Part_Number AP2139AK-3.3TRG1; Mouser Part Number 621-AP2139AK-3.3TRG1
L2: 7447709330‎ 33uH 4.2A 45MOHM; WE-PD_1260%2f1245%2f1280%2f121054
R2: 33k 5%; R_0805_2012Metric
R3: 3k3 5%; R_0805_2012Metric
R22: 100k %5; R_0805_2012Metric
R23: 100k 1%; R_0805_2012Metric
R24: 9.09 1%; R_0805_2012Metric
R25: 10k 5%; R_0805_2012Metric
R36: 1k2 5%; R_0805_2012Metric
R39: 47k %5; R_0805_2012Metric

Connections:
12V_CTRL: IC5.3 (EN), R39.2; also elsewhere on the board
+3V3: C1.1, D9.2 (A), IC9.5 (VOUT); also elsewhere on the board
+5V: C3.1, C29.1, D3.2 (A), IC2.5 (OUT), IC2.6 (FB), IC9.1 (VIN), IC9.3 (CE); also elsewhere on the board
+12V: C23.1, C24.1, D8.2 (A), L2.2, R23.2; also elsewhere on the board
GND: C1.2, C3.2, C4.2, C5.2, C21.2, C23.2, C24.2, C28.2, C29.2, IC2.2 (GND), IC5.1 (PGND), IC5.9 (EP), IC9.2 (GND), R2.2, R3.2, R24.1, R25.2, R36.2, R39.1; also elsewhere on the board
unnamed: C4.1, IC2.7 (VCC)
unnamed: C21.1, IC5.6 (VCC)
unnamed: C22.1, IC5.8 (SW), L2.1, R22.2
unnamed: C22.2, IC5.7 (BOOT)
unnamed: D2.1 (K), R2.1
unnamed: D3.1 (K), R3.1
unnamed: D8.1 (K), R25.1
unnamed: D9.1 (K), R36.1
unnamed: IC5.4 (PG), R22.1
unnamed: IC5.5 (FB), R23.1, R24.2
VCC: C5.1, C28.1, D2.2 (A), IC2.8 (EN/UVLO), IC2.9 (VIN_1), IC2.10 (VIN_2), IC5.2 (VIN); also elsewhere on the board

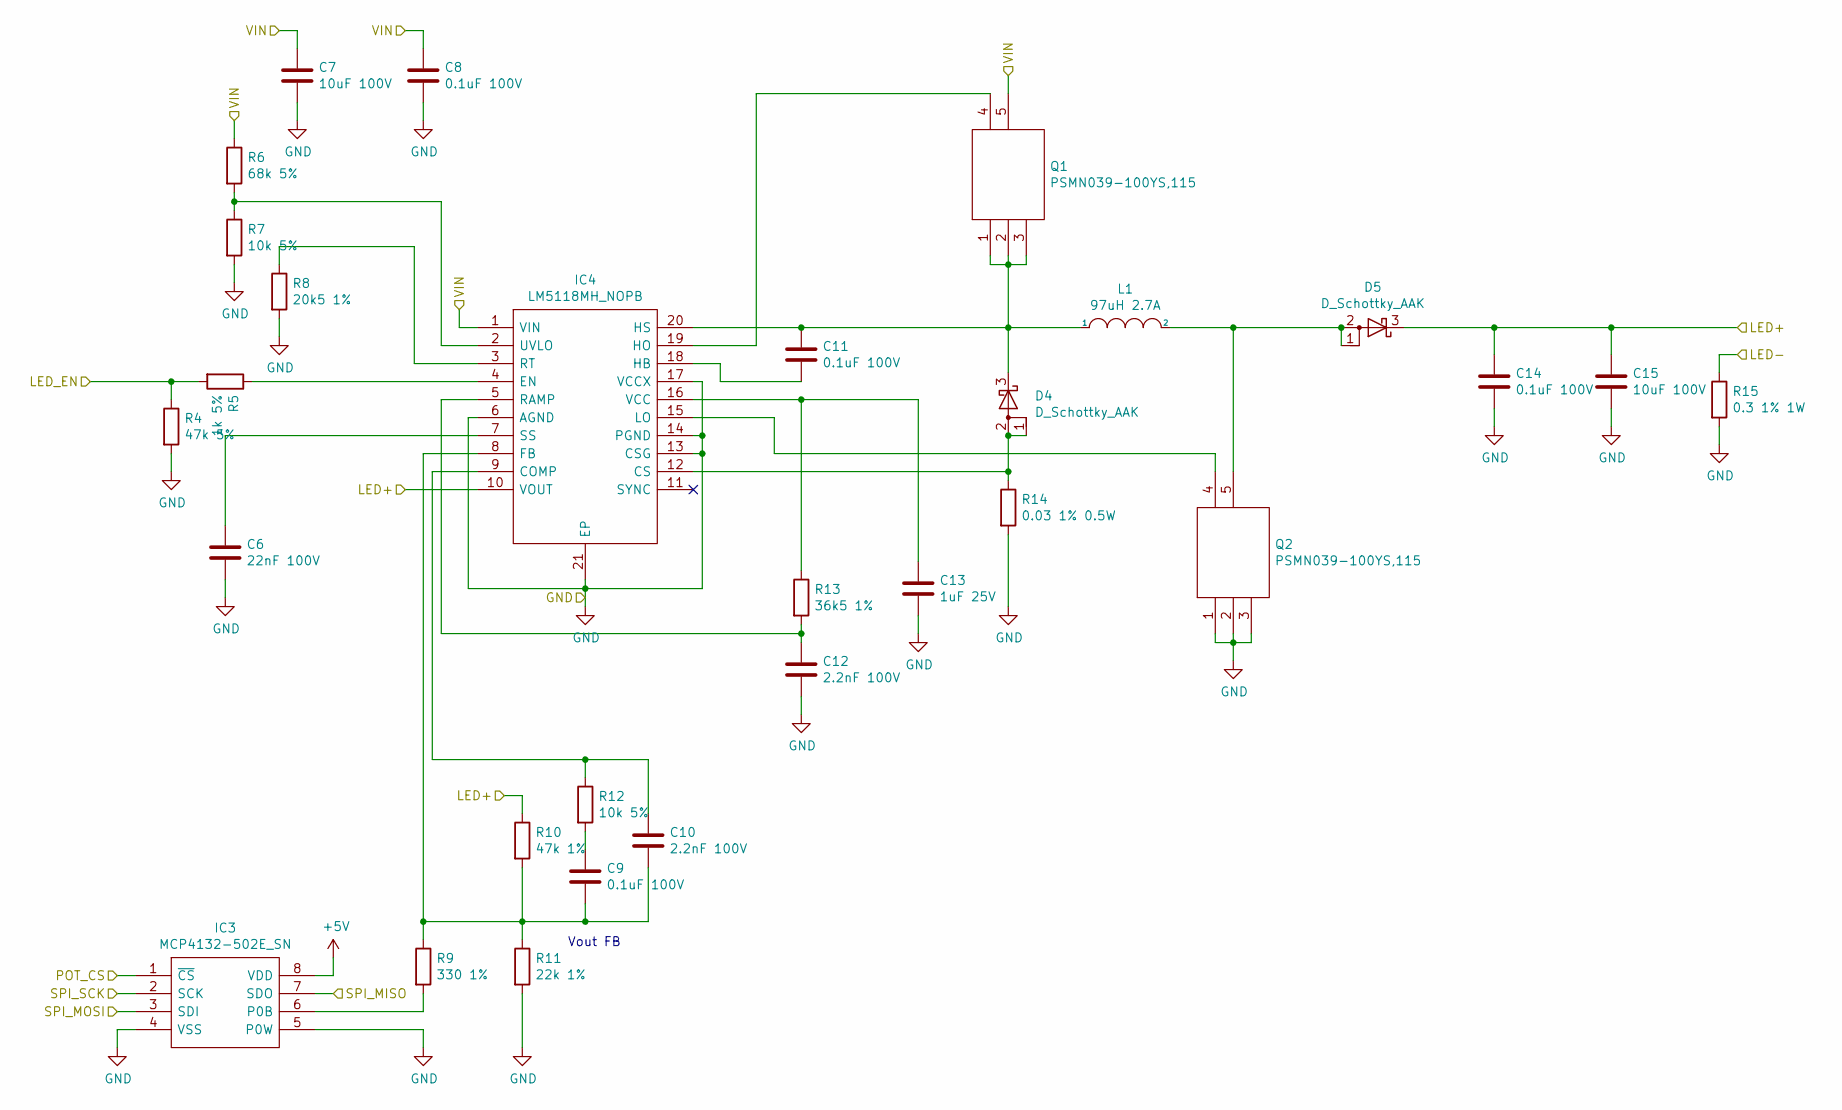
[picture p47: schematic LM5118Driver.sch]

Parts:
C6: 22nF 100V; C_0805_2012Metric
C7, C15: 10uF 100V; C_1210_3225Metric
C8, C9, C11, C14: 0.1uF 100V; C_0805_2012Metric
C10, C12: 2.2nF 100V; C_0805_2012Metric
C13: 1uF 25V; C_0805_2012Metric
D4, D5: D_Schottky_AAK; TO-277A
IC3: MCP4132-502E_SN; TSSOP-8_3x3mm_P0.65mm; Manufacturer_Part_Number MCP4132-502E/SN; Mouser Part Number 579-MCP4132-502E/SN
IC4: LM5118MH_NOPB; SOP65P640X110-21N; Manufacturer_Part_Number LM5118MH/NOPB; Mouser Part Number 926-LM5118MH/NOPB
L1: 97uH 2.7A; ‎ETQ-P5M101YGC‎ Inductor
Q1, Q2: PSMN039-100YS,115; PSMN5R660YLX; Manufacturer_Part_Number PSMN039-100YS,115; Mouser Part Number 771-PSMN039-100YS115
R4: 47k 5%; R_0805_2012Metric
R5: 1k 5%; R_0805_2012Metric
R6: 68k 5%; R_0805_2012Metric
R7, R12: 10k 5%; R_0805_2012Metric
R8: 20k5 1%; R_0805_2012Metric
R9: 330 1%; R_0805_2012Metric
R10: 47k 1%; R_0805_2012Metric
R11: 22k 1%; R_0805_2012Metric
R13: 36k5 1%; R_0805_2012Metric
R14: 0.03 1% 0.5W; R_1206_3216Metric
R15: 0.3 1% 1W; R_2512_6332Metric

Connections:
+5V: IC3.8 (VDD); also elsewhere on the board
GND: C6.2, C7.2, C8.2, C12.2, C13.2, C14.2, C15.2, IC3.4 (VSS), IC3.5 (P0W), IC4.6 (AGND), IC4.13 (CSG), IC4.14 (PGND), IC4.17 (VCCX), IC4.21 (EP), Q2.1, Q2.2, Q2.3, R4.2, R7.2, R8.2, R11.2, R14.2, R15.2; also elsewhere on the board
LED+: C14.1, C15.1, D5.3 (K), IC4.10 (VOUT), R10.1; also elsewhere on the board
LED-: R15.1; also elsewhere on the board
LEDCTRL: R4.1, R5.2; also elsewhere on the board
unnamed: C6.1, IC4.7 (SS)
unnamed: C9.1, R12.2
unnamed: C10.1, IC4.9 (COMP), R12.1
unnamed: C9.2, C10.2, IC4.8 (FB), R9.1, R10.2, R11.1
unnamed: C11.1, D4.3 (K), IC4.20 (HS), L1.1, Q1.1, Q1.2, Q1.3
unnamed: C11.2, IC4.18 (HB)
unnamed: C12.1, IC4.5 (RAMP), R13.2
unnamed: C13.1, IC4.16 (VCC), R13.1
unnamed: D4.1 (A), D4.2 (A), IC4.12 (CS), R14.1
unnamed: D5.1 (A), D5.2 (A), L1.2, Q2.5
unnamed: IC3.6 (P0B), R9.2
unnamed: IC4.2 (UVLO), R6.2, R7.1
unnamed: IC4.3 (RT), R8.1
unnamed: IC4.4 (EN), R5.1
unnamed: IC4.15 (LO), Q2.4
unnamed: IC4.19 (HO), Q1.4
SPI_DPOT_CS: IC3.1 (~CS); also elsewhere on the board
SPI_MISO: IC3.7 (SDO); also elsewhere on the board
SPI_MOSI: IC3.3 (SDI); also elsewhere on the board
SPI_SCK: IC3.2 (SCK); also elsewhere on the board
VCC: C7.1, C8.1, IC4.1 (VIN), Q1.5, R6.1; also elsewhere on the board

Notes on the sheet:
Vout FB

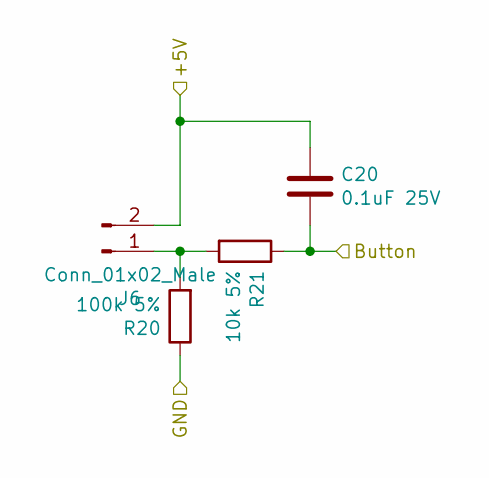
[picture p48: schematic Button.sch]

Parts:
C20: 0.1uF 25V; C_0805_2012Metric
J6: Conn_01x02_Male; 2WirePad
R20: 100k 5%; R_0805_2012Metric
R21: 10k 5%; R_0805_2012Metric

Connections:
+5V: C20.1, J6.2; also elsewhere on the board
Button: C20.2, R21.1; also elsewhere on the board
GND: R20.1; also elsewhere on the board
unnamed: J6.1, R20.2, R21.2

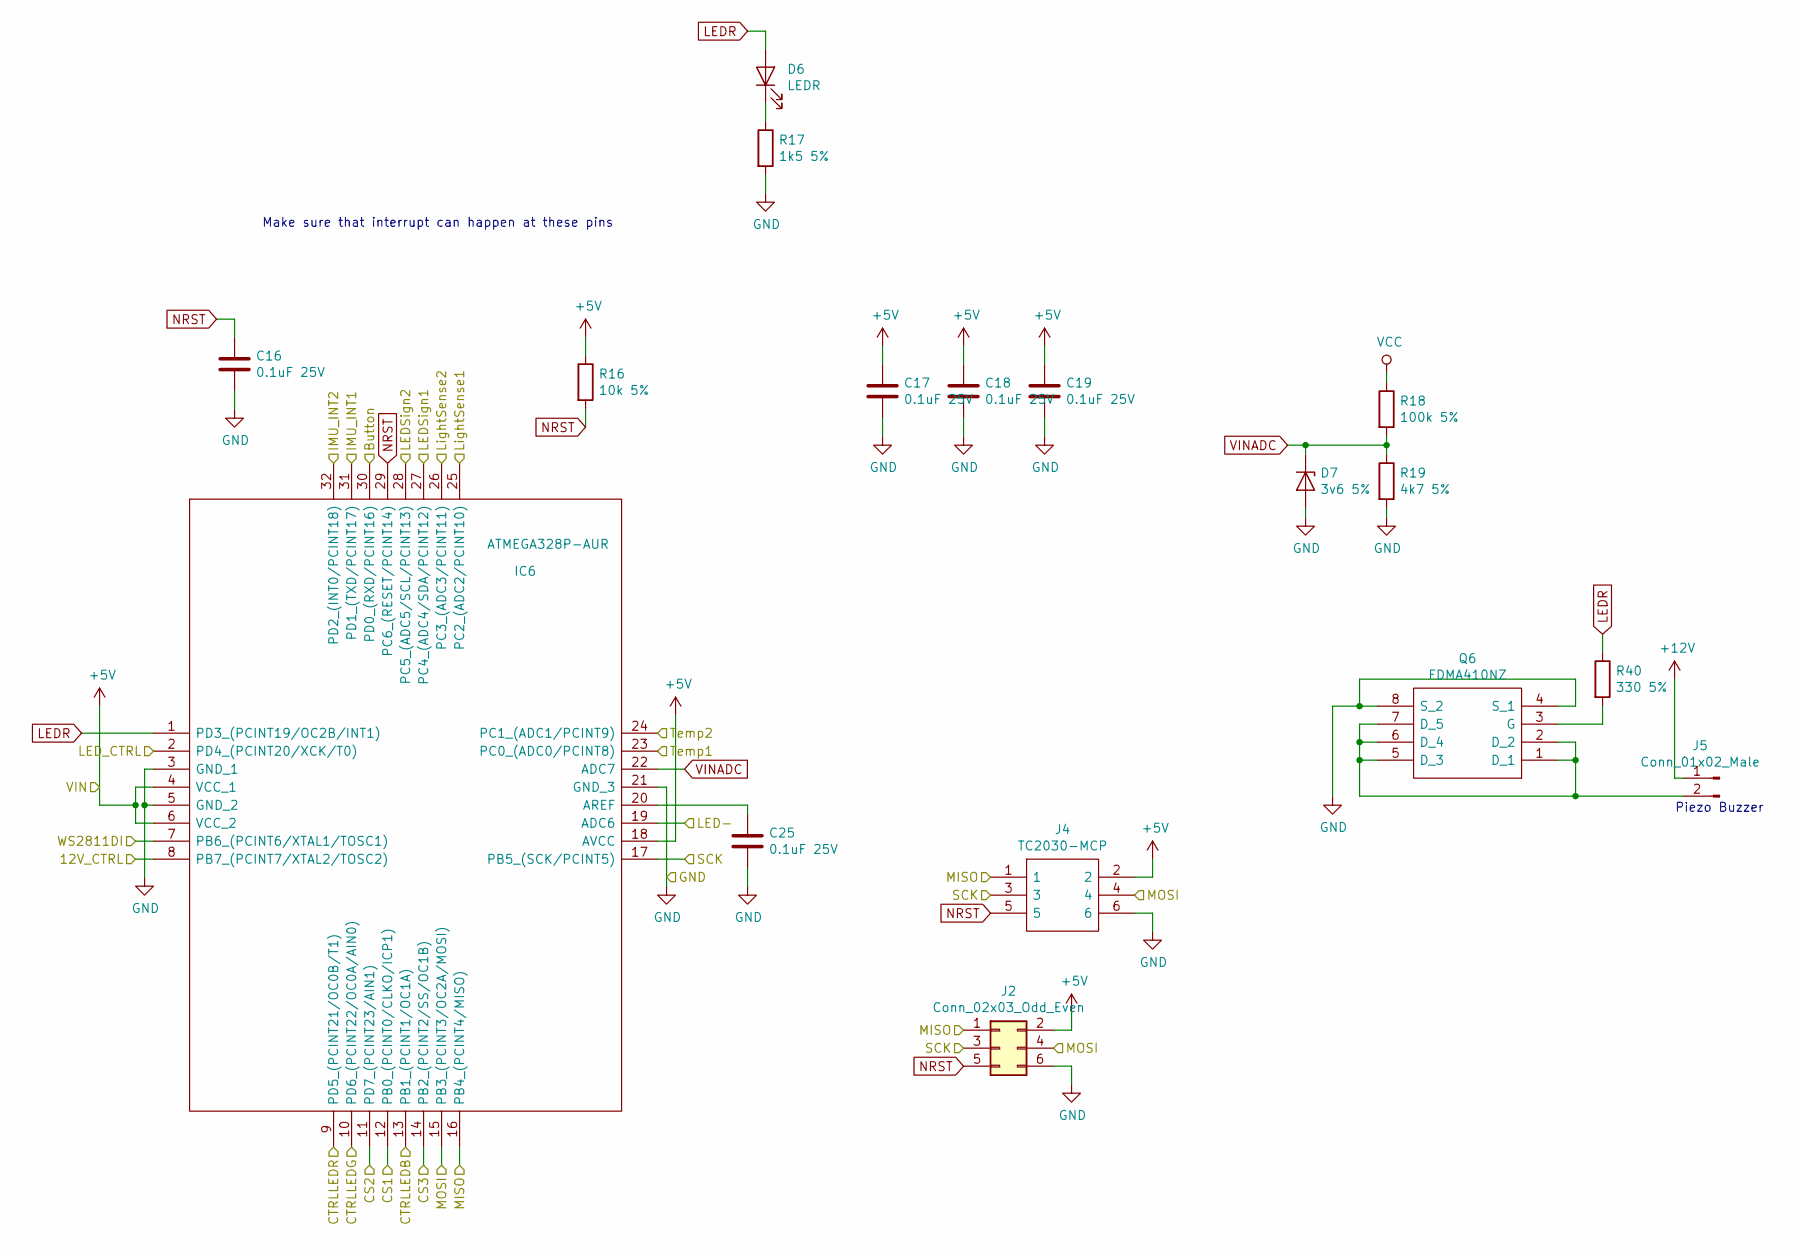
[picture p49: schematic MCU.sch]

Parts:
C16, C17, C18, C19, C25: 0.1uF 25V; C_0805_2012Metric
D6: LEDR; LED_0805_2012Metric
D7: 3v6 5%; D_SOD-323
IC6: ATMEGA328P-AUR; TQFP-32_7x7mm_P0.8mm; Manufacturer_Part_Number ATMEGA328P-AUR; Mouser Part Number 556-ATMEGA328P-AUR
J2: Conn_02x03_Odd_Even; PinHeader_2x03_P2.54mm_Vertical
J4: TC2030-MCP; TC2030MCP; Manufacturer_Part_Number TC2030-MCP; Mouser Part Number 579-TC2030-MCP
J5: Conn_01x02_Male; 2WirePad
Q6: FDMA410NZ; Manufacturer_Part_Number FDMA410NZ; Mouser Part Number 512-FDMA410NZ
R16: 10k 5%; R_0805_2012Metric
R17: 1k5 5%; R_0805_2012Metric
R18: 100k 5%; R_0805_2012Metric
R19: 4k7 5%; R_0805_2012Metric
R40: 330 5%; R_0805_2012Metric

Connections:
12V_CTRL: IC6.8 (PB7_(PCINT7/XTAL2/TOSC2)); also elsewhere on the board
+5V: C17.1, C18.1, C19.1, IC6.4 (VCC_1), IC6.6 (VCC_2), IC6.18 (AVCC), J2.2, J4.2, R16.1; also elsewhere on the board
+12V: J5.1; also elsewhere on the board
Button: IC6.30 (PD0_(RXD/PCINT16)); also elsewhere on the board
CTRLLEDB: IC6.13 (PB1_(PCINT1/OC1A)); also elsewhere on the board
CTRLLEDG: IC6.10 (PD6_(PCINT22/OC0A/AIN0)); also elsewhere on the board
CTRLLEDR: IC6.9 (PD5_(PCINT21/OC0B/T1)); also elsewhere on the board
GND: C16.2, C17.2, C18.2, C19.2, C25.2, D7.2 (A), IC6.3 (GND_1), IC6.5 (GND_2), IC6.21 (GND_3), J2.6, J4.6, Q6.4 (S_1), Q6.8 (S_2), R17.2, R19.2; also elsewhere on the board
IMU_INT1: IC6.31 (PD1_(TXD/PCINT17)); also elsewhere on the board
IMU_INT2: IC6.32 (PD2_(INT0/PCINT18)); also elsewhere on the board
LED-: IC6.19 (ADC6); also elsewhere on the board
LEDCTRL: IC6.2 (PD4_(PCINT20/XCK/T0)); also elsewhere on the board
LEDR: D6.2 (A), IC6.1 (PD3_(PCINT19/OC2B/INT1)), R40.1
LEDSign1: IC6.27 (PC4_(ADC4/SDA/PCINT12)); also elsewhere on the board
LEDSign2: IC6.28 (PC5_(ADC5/SCL/PCINT13)); also elsewhere on the board
LightSense1: IC6.25 (PC2_(ADC2/PCINT10)); also elsewhere on the board
LightSense2: IC6.26 (PC3_(ADC3/PCINT11)); also elsewhere on the board
NRST: C16.1, IC6.29 (PC6_(RESET/PCINT14)), J2.5, J4.5, R16.2
unnamed: C25.1, IC6.20 (AREF)
unnamed: D6.1 (K), R17.1
unnamed: J5.2, Q6.1 (D_1), Q6.2 (D_2), Q6.5 (D_3), Q6.6 (D_4), Q6.7 (D_5)
unnamed: Q6.3 (G), R40.2
SPI_CAN_CS: IC6.14 (PB2_(PCINT2/SS/OC1B)); also elsewhere on the board
SPI_DPOT_CS: IC6.11 (PD7_(PCINT23/AIN1)); also elsewhere on the board
SPI_IMU_CS: IC6.12 (PB0_(PCINT0/CLKO/ICP1)); also elsewhere on the board
SPI_MISO: IC6.16 (PB4_(PCINT4/MISO)), J2.1, J4.1; also elsewhere on the board
SPI_MOSI: IC6.15 (PB3_(PCINT3/OC2A/MOSI)), J2.4, J4.4; also elsewhere on the board
SPI_SCK: IC6.17 (PB5_(SCK/PCINT5)), J2.3, J4.3; also elsewhere on the board
Temp1: IC6.23 (PC0_(ADC0/PCINT8)); also elsewhere on the board
Temp2: IC6.24 (PC1_(ADC1/PCINT9)); also elsewhere on the board
VCC: R18.1; also elsewhere on the board
VINADC: D7.1 (K), IC6.22 (ADC7), R18.2, R19.1
WS2811DI: IC6.7 (PB6_(PCINT6/XTAL1/TOSC1)); also elsewhere on the board

Notes on the sheet:
Make sure that interrupt can happen at these pins
Piezo Buzzer
