dannyandreev/BOM-Lights/Electrical/SkateLightMainBoard/SkateLightMainBoard3.3/SkateLightMainBoard.kicad_pcb

## KiCad design Electrical/SkateLightMainBoard/SkateLightMainBoard3.3/SkateLightMainBoard.kicad_pcb (continued)

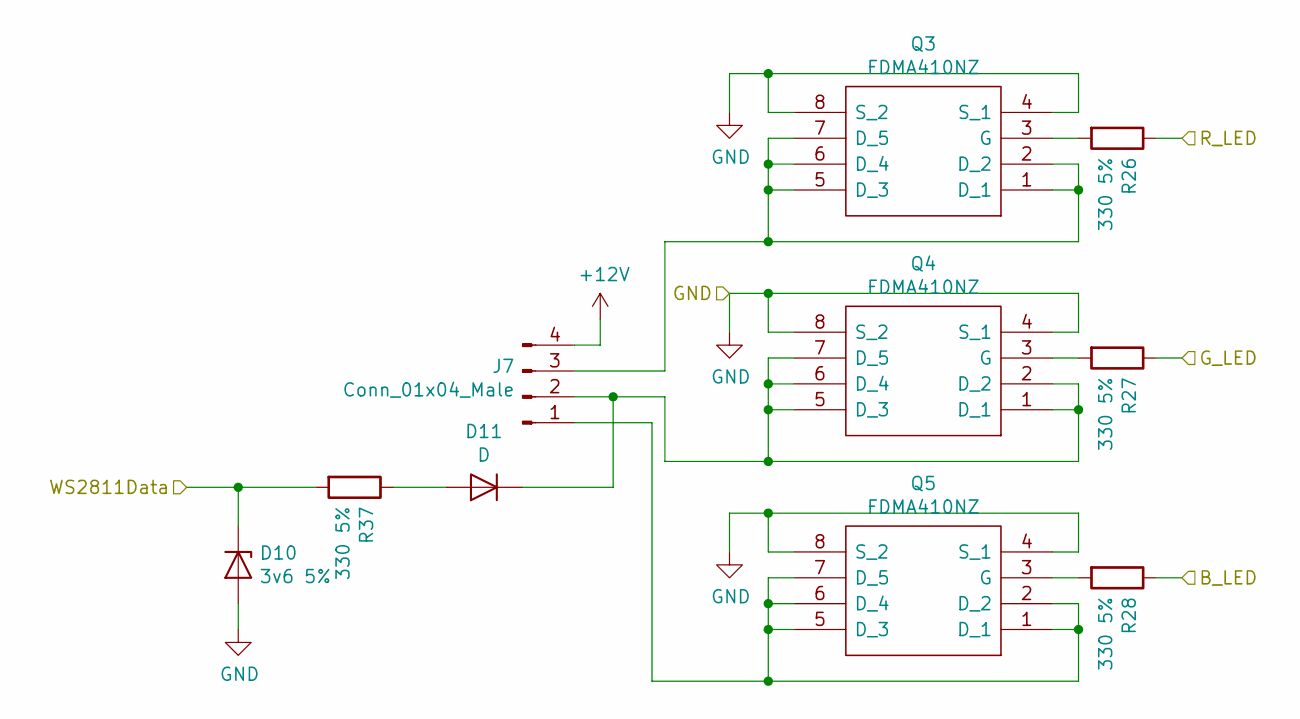
[picture p50: schematic 12V RGB LED.sch]

Parts:
D10: 3v6 5%; D_SOD-323
D11: D; D_SOD-323
J7: Conn_01x04_Male; 4 Wire Pad
Q3, Q4, Q5: FDMA410NZ; Manufacturer_Part_Number FDMA410NZ; Mouser Part Number 512-FDMA410NZ
R26, R27, R28, R37: 330 5%; R_0805_2012Metric

Connections:
+12V: J7.4; also elsewhere on the board
CTRLLEDB: R28.1; also elsewhere on the board
CTRLLEDG: R27.1; also elsewhere on the board
CTRLLEDR: R26.1; also elsewhere on the board
GND: D10.2 (A), Q3.4 (S_1), Q3.8 (S_2), Q4.4 (S_1), Q4.8 (S_2), Q5.4 (S_1), Q5.8 (S_2); also elsewhere on the board
unnamed: D11.1 (K), J7.2, Q4.1 (D_1), Q4.2 (D_2), Q4.5 (D_3), Q4.6 (D_4), Q4.7 (D_5)
unnamed: D11.2 (A), R37.1
unnamed: J7.1, Q5.1 (D_1), Q5.2 (D_2), Q5.5 (D_3), Q5.6 (D_4), Q5.7 (D_5)
unnamed: J7.3, Q3.1 (D_1), Q3.2 (D_2), Q3.5 (D_3), Q3.6 (D_4), Q3.7 (D_5)
unnamed: Q3.3 (G), R26.2
unnamed: Q4.3 (G), R27.2
unnamed: Q5.3 (G), R28.2
WS2811DI: D10.1 (K), R37.2; also elsewhere on the board

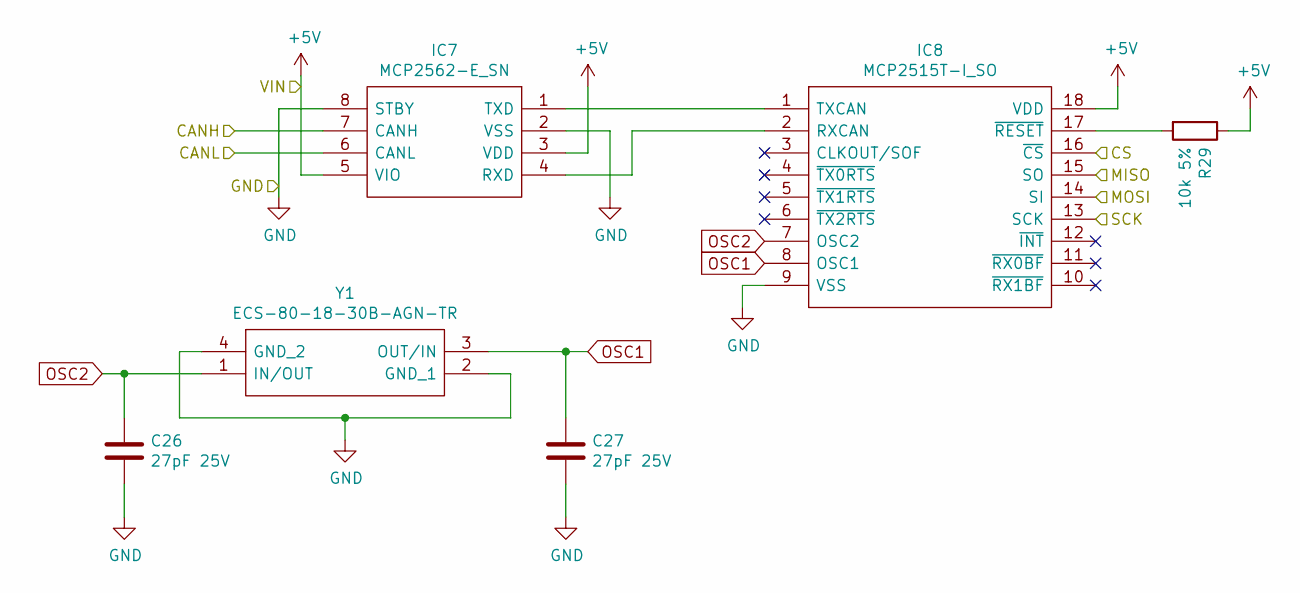
[picture p51: schematic CAN Controller.sch]

Parts:
C26, C27: 27pF 25V; C_0805_2012Metric
IC7: MCP2562-E_SN; SOIC127P600X175-8N; Manufacturer_Part_Number MCP2562-E/SN; Mouser Part Number 579-MCP2562-E/SN
IC8: MCP2515T-I_SO; SOIC127P1030X265-18N; Manufacturer_Part_Number MCP2515T-I/SO; Mouser Part Number 579-MCP2515T-I/SO
R29: 10k 5%; R_0805_2012Metric
Y1: ECS-80-18-30B-AGN-TR; ECS801830BAGNTR; Manufacturer_Part_Number ECS-80-18-30B-AGN-TR; Mouser Part Number 520-80-18-30B-AGNT

Connections:
+5V: IC7.3 (VDD), IC7.5 (VIO), IC8.18 (VDD), R29.1; also elsewhere on the board
/CAN Controller/CANH: IC7.7 (CANH); also elsewhere on the board
/CAN Controller/CANL: IC7.6 (CANL); also elsewhere on the board
GND: C26.2, C27.2, IC7.2 (VSS), IC7.8 (STBY), IC8.9 (VSS), Y1.2 (GND_1), Y1.4 (GND_2); also elsewhere on the board
unnamed: IC7.1 (TXD), IC8.1 (TXCAN)
unnamed: IC7.4 (RXD), IC8.2 (RXCAN)
unnamed: IC8.17 (~RESET), R29.2
OSC1: C27.1, IC8.8 (OSC1), Y1.3 (OUT/IN)
OSC2: C26.1, IC8.7 (OSC2), Y1.1 (IN/OUT)
SPI_CAN_CS: IC8.16 (~CS); also elsewhere on the board
SPI_MISO: IC8.15 (SO); also elsewhere on the board
SPI_MOSI: IC8.14 (SI); also elsewhere on the board
SPI_SCK: IC8.13 (SCK); also elsewhere on the board

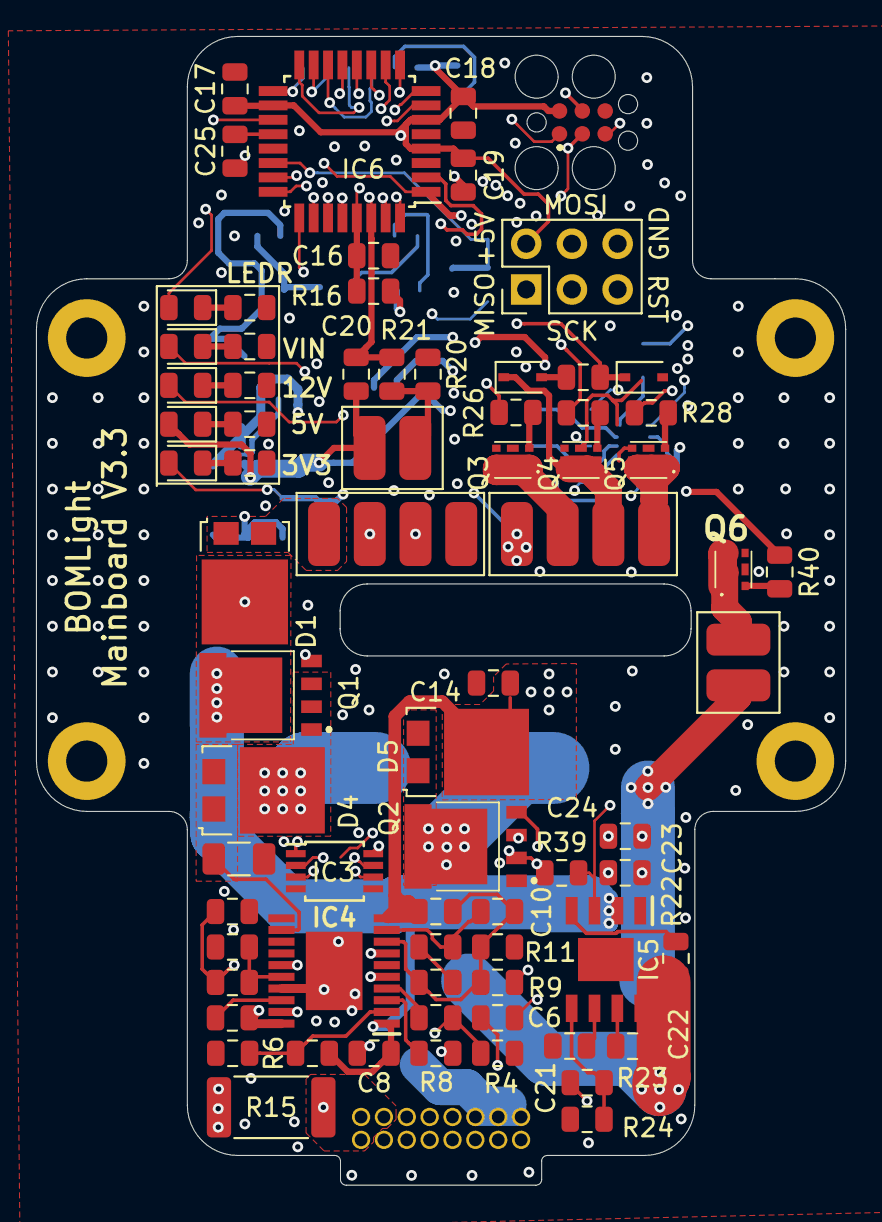
[picture p52: board Electrical/SkateLightMainBoard/SkateLightMainBoard3.3/SkateLightMainB… from above]

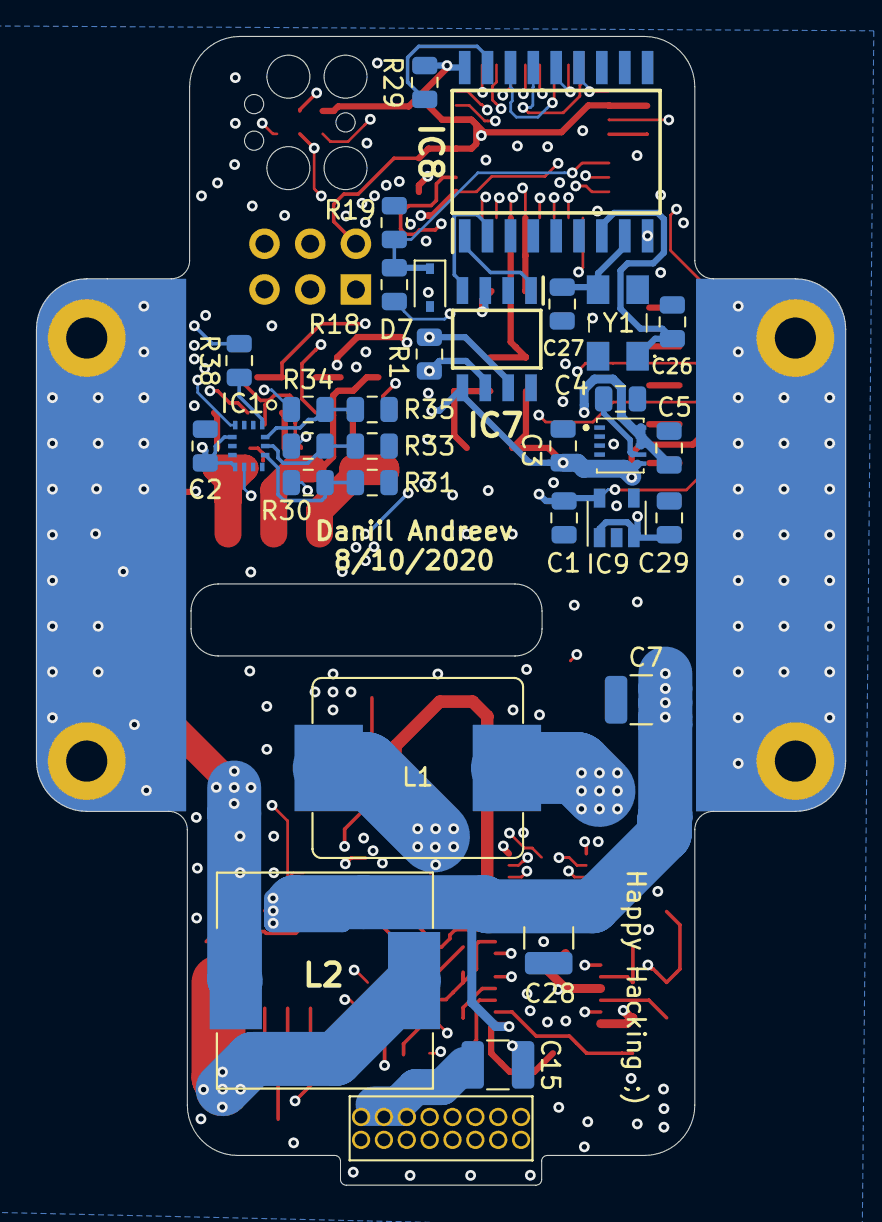
[picture p53: board Electrical/SkateLightMainBoard/SkateLightMainBoard3.3/SkateLightMainB… from below]

Board: 4 copper layers, 45.0 x 63.8 mm, 107 parts (32 on the bottom side), 81 nets.
