dannyandreev/BOM-Lights/Electrical/SkateLightMainBoard/SkateLightMainBoard3.0/SkateLightMainBoard.kicad_pcb

## KiCad design Electrical/SkateLightMainBoard/SkateLightMainBoard3.0/SkateLightMainBoard.kicad_pcb (2022-03-13)

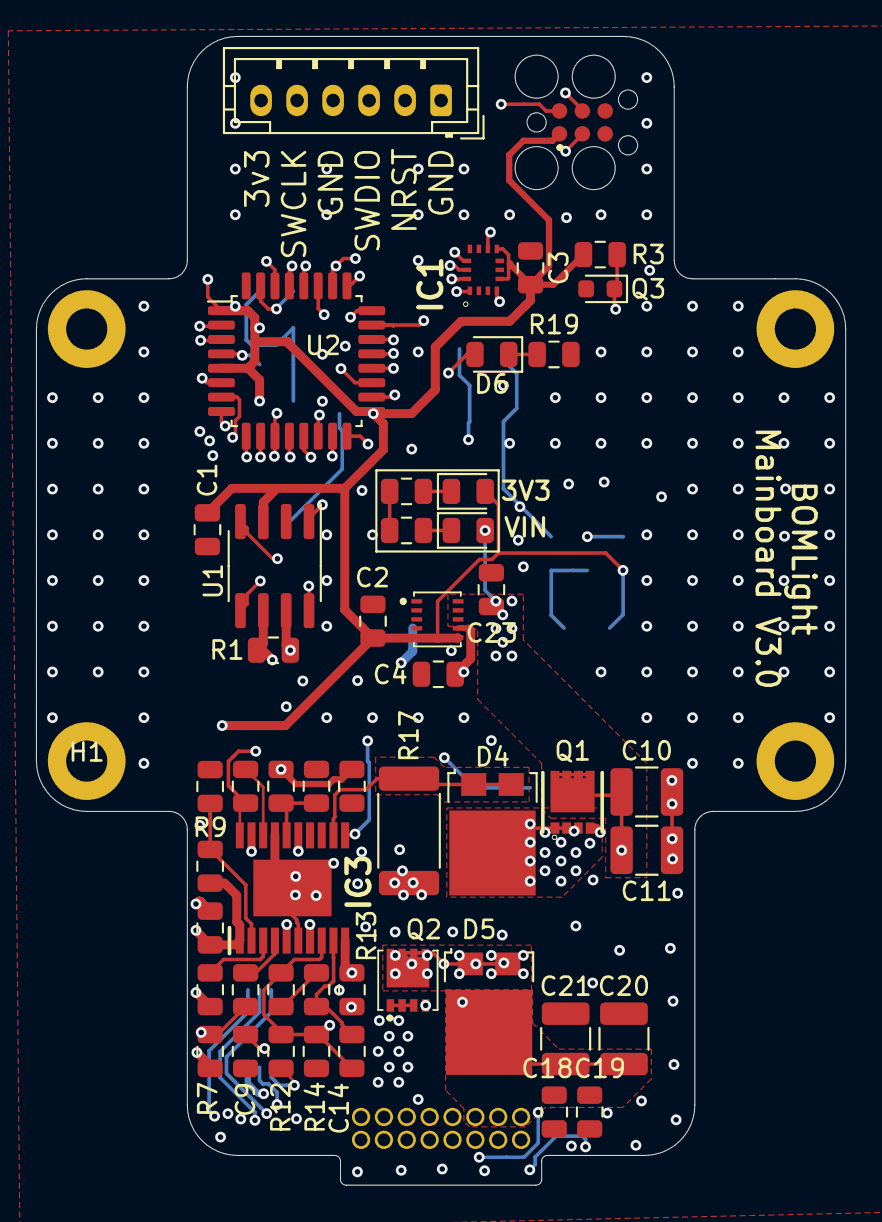
[picture p54: board Electrical/SkateLightMainBoard/SkateLightMainBoard3.0/SkateLightMainB… from above]

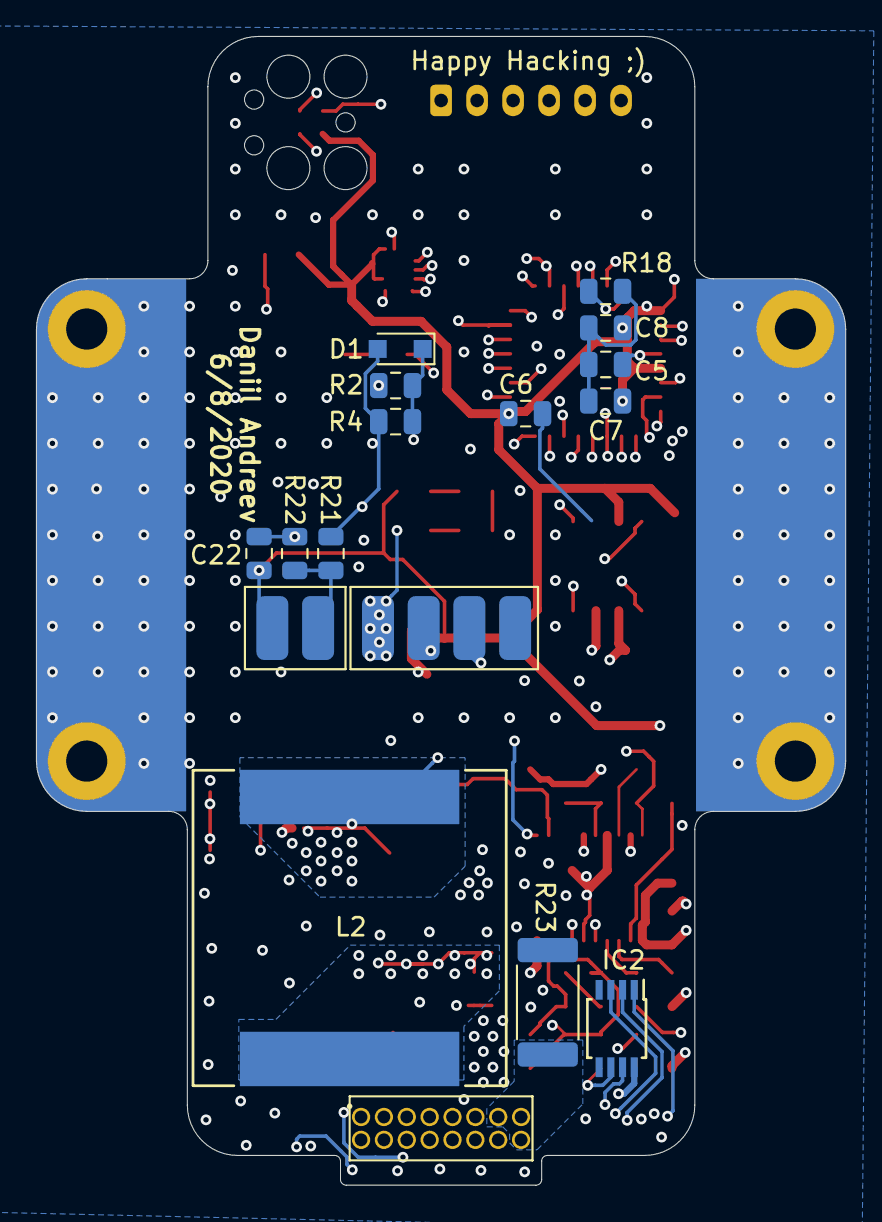
[picture p55: board Electrical/SkateLightMainBoard/SkateLightMainBoard3.0/SkateLightMainB… from below]

Board: 4 copper layers, 45.0 x 63.8 mm, 68 parts (17 on the bottom side), 55 nets.

Parts:
C1, C3, C5, C6, C7, C8, C15, C22: 100nF; C_0805_2012Metric
C2: 10uF; C_0805_2012Metric
C4, C17, C23: 1uF; C_0805_2012Metric
C9: 22nF; C_0805_2012Metric
C10, C11, C20, C21: 10uF; C_1210_3225Metric
C12: 0.1uF; C_0805_2012Metric
C13: 220nF; C_0805_2012Metric
C14: 6.8nF; C_0805_2012Metric
C16: 2.2nF; C_0805_2012Metric
C18, C19: 0.47uF; C_0805_2012Metric
D1: D_Zener; D_SOD-323_HandSoldering
D2, D3: LEDO; LED_0805_2012Metric
D4, D5: D_Schottky_AAK; TO-277A
D6: LEDR; LED_0805_2012Metric
H1, H2: MountingHole_Pad; ThermalPadV2_SkateLight
IC1: LSM6DS3USTR; LGA-14(2.5X3X0.86)
IC2: MCP4132-502E_SN; TSSOP-8_3x3mm_P0.65mm
IC3: LM5118MH_NOPB; SOP65P640X110-21N
IC4: MAXM15062AMB+; MAXM15462AMB
J1: Conn_01x04_Male; 4 Wire Pad
J2: TC2030-MCP; TC2030MCP
J3: Conn_01x02_Male; 2WirePad
J4: Conn_02x08_Odd_Even; Conn_2x8_0.05in
J5: Conn_01x06_Male; JST_PH_B6B-PH-K_1x06_P2.00mm_Vertical
L2: IHLP6767GZER470M11
Q1: CSD19537Q3; DQG_VSON-CLIP
Q2: FDMC86240; FDMC86139P
Q3: Q_Photo_NPN; D_0603_1608Metric
R1: 120; R_0805_2012Metric
R2, R14, R21: 100k; R_0805_2012Metric
R3: R; R_0805_2012Metric
R4: 180k; R_0805_2012Metric
R5: 33k; R_0805_2012Metric
R6: 1k2; R_0805_2012Metric
R7: 47k; R_0805_2012Metric
R8: 1k; R_0805_2012Metric
R9: 68k; R_0805_2012Metric
R10, R18, R22: 10k; R_0805_2012Metric
R11: 20k5; R_0805_2012Metric
R12: 4k7; R_0805_2012Metric
R13: 220k; R_0805_2012Metric
R15: 5k62; R_0805_2012Metric
R16: 36k5; R_0805_2012Metric
R17: 0.05; R_2512_6332Metric
R19: 1k5; R_0805_2012Metric
R23: .5; R_2512_6332Metric
U1: SN65HVD233; SOIC-8_3.9x4.9mm_P1.27mm
U2: STM32F042K6Tx; LQFP-32_7x7mm_P0.8mm

Connections:
+3V3: C1.1, C2.1, C3.1, C6.1, C7.1, C8.1, C22.1, D3.2, IC1.5, IC1.8, IC2.8, IC4.5, IC4.6, J2.1, J3.2, J4.13, J5.6, R3.1, U1.3, U2.1, U2.5, U2.17
Button: C22.2, R22.1, U2.8
CAN_LBK: U1.5, U2.19
CAN_RX: U1.4, U2.22
CAN_Rs: U1.8, U2.20
CAN_TX: U1.1, U2.21
GND: C1.2, C2.2, C3.2, C4.2, C5.2, C6.2, C7.2, C8.2, C9.2, C10.2, C11.2, C12.2, C16.2, C17.2, C18.2, C19.2, C20.2, C21.2, C23.2, D1.2, H1.1, H2.1, IC1.2, IC1.3, IC1.6, IC1.7, IC2.4, IC2.5, IC3.6, IC3.13, IC3.14, IC3.17, IC3.21, IC4.2, J1.1, J2.5, J4.7, J5.1, J5.4, Q2.1, Q2.2, Q2.3, Q3.2, R4.2, R5.2, R6.2, R7.2, R10.2, R11.2, R14.2, R17.2, R18.2, R19.2, R21.1, R23.2, U1.2, U2.16, U2.32
IMU_INT1: IC1.4, U2.14
IMU_INT2: IC1.9, U2.18
LED+: C18.1, C19.1, C20.1, C21.1, D5.3, IC3.10, J4.2, J4.4, J4.6, R13.1
LED-: J4.14, J4.15, J4.16, R23.1, U2.12
LEDCTRL: R7.1, R8.2, U2.13
LEDR: D6.2, U2.25
LEDSign1: J4.11, U2.2
LEDSign2: J4.12, U2.3
LightSense1: J4.8, U2.7
LightSense2: J4.9, U2.9
LightSense3: J4.5, Q3.1, R3.2, U2.11
NRST: C5.1, J2.3, J5.2, U2.4
unnamed: C4.1, IC4.7
unnamed: C9.1, IC3.7
unnamed: C13.1, R15.2
unnamed: C13.2, C14.2, IC3.8, R12.1, R13.2, R14.1
unnamed: C14.1, IC3.9, R15.1
unnamed: C15.1, D4.3, IC3.20, L2.2, Q1.1, Q1.2, Q1.3
unnamed: C15.2, IC3.18
unnamed: C16.1, IC3.5, R16.2
unnamed: C17.1, IC3.16, R16.1
unnamed: D1.1, R2.1, R4.1, U2.15
unnamed: D2.1, R5.1
unnamed: D3.1, R6.1
unnamed: D4.1, D4.2, IC3.12, R17.1
unnamed: D5.1, D5.2, L2.1, Q2.5, Q2.6, Q2.7, Q2.8
unnamed: D6.1, R19.1
unnamed: IC2.6, R12.2
unnamed: IC3.2, R9.2, R10.1
unnamed: IC3.3, R11.1
unnamed: IC3.4, R8.1
unnamed: IC3.15, Q2.4
unnamed: IC3.19, Q1.4
unnamed: J1.2, R1.1, U1.6
unnamed: J1.3, R1.2, U1.7
unnamed: J3.1, R21.2, R22.2
unnamed: R18.1, U2.31
SPI1_DPOT_CS: IC2.1, U2.30
SPI1_IMU_CS: IC1.12, U2.29
SPI1_MISO: IC1.1, IC2.7, U2.27
SPI1_MOSI: IC1.14, IC2.3, U2.28
SPI1_SCK: IC1.13, IC2.2, U2.26
SWCLK: J2.4, J5.5, U2.24
SWDIO: J2.2, J5.3, U2.23
SYNC: IC3.11, R2.2
Temp1: J4.10, U2.6
Temp2: J4.1, U2.10
VCC: C10.1, C11.1, C12.1, C23.1, D2.2, IC3.1, IC4.8, IC4.9, IC4.10, J1.4, Q1.5, Q1.6, Q1.7, Q1.8, R9.1
