dannyandreev/BOM-Lights/Electrical/SkateLightConnBoard/SkateLightConnBoard1.1/SkateLightConnBoard.kicad_pcb

## KiCad design Electrical/SkateLightConnBoard/SkateLightConnBoard1.1/SkateLightConnBoard.kicad_pcb (2022-03-13)

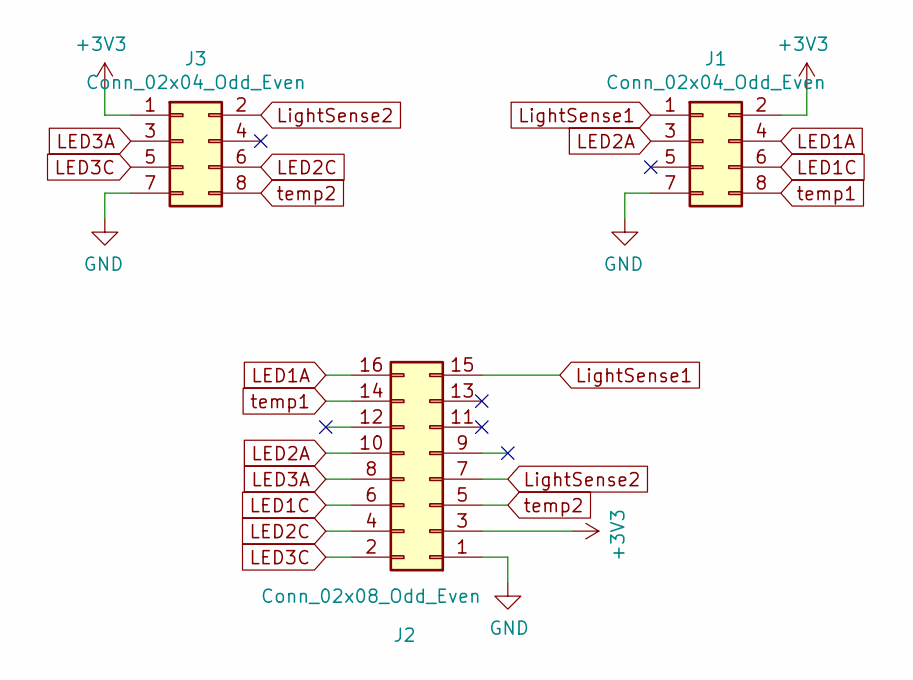
[picture p56: schematic SkateLightConnBoard.sch]

Parts:
J1, J3: Conn_02x04_Odd_Even; Conn_2x4_0.05in
J2: Conn_02x08_Odd_Even; Conn_2x8_0.05in

Connections:
+3V3: J1.2, J2.3, J3.1
GND: J1.7, J2.1, J3.7
LED1A: J1.4, J2.16
LED1C: J1.6, J2.6
LED2A: J1.3, J2.10
LED2C: J2.4, J3.6
LED3A: J2.8, J3.3
LED3C: J2.2, J3.5
LightSense1: J1.1, J2.15
LightSense2: J2.7, J3.2
temp1: J1.8, J2.14
temp2: J2.5, J3.8

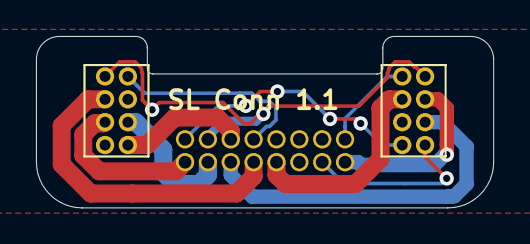
[picture p57: board Electrical/SkateLightConnBoard/SkateLightConnBoard1.1/SkateLightConnB… from above]

Board: 2 copper layers, 25.4 x 9.5 mm, 3 parts (1 on the bottom side), 12 nets.
