dannyandreev/BOM-Lights/Electrical/SkateLightLEDBoard/SkateLightLEDBoard1.6/SkateLightLEDBoard.kicad_pcb

## KiCad design Electrical/SkateLightLEDBoard/SkateLightLEDBoard1.6/SkateLightLEDBoard.kicad_pcb (2022-03-13)

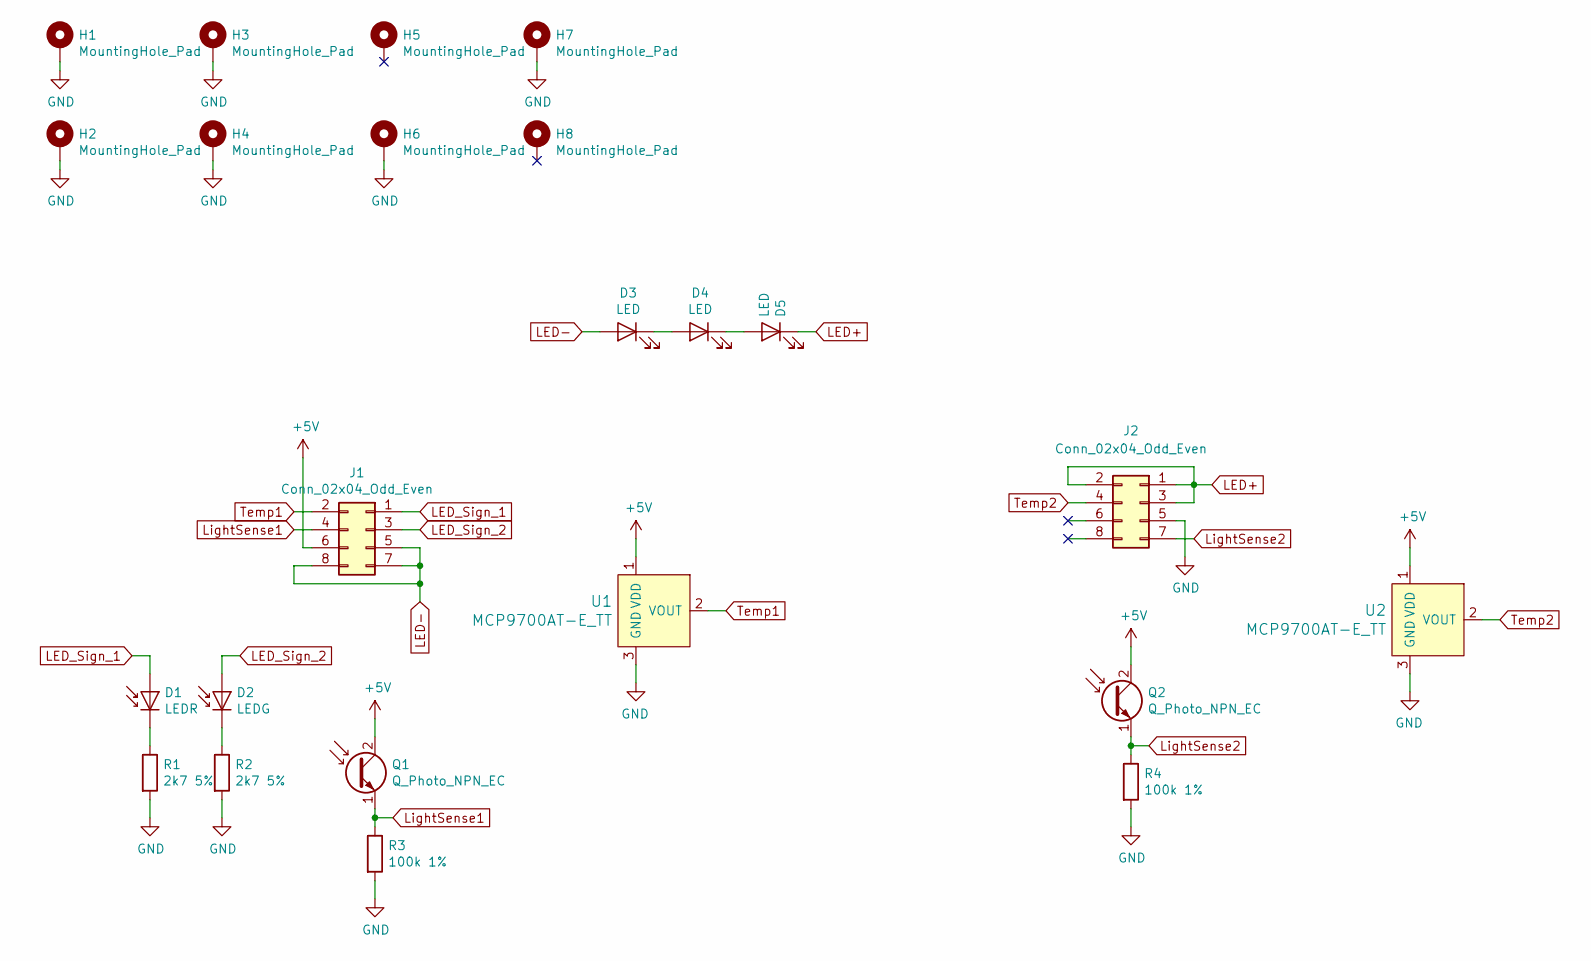
[picture p61: schematic SkateLightLEDBoard.sch]

Parts:
D1: LEDR; D_0402_1005Metric
D2: LEDG; D_0402_1005Metric
D3, D4, D5: LED; BXRE-40E0800-D-73
H1, H2, H3, H4, H5, H6, H7, H8: MountingHole_Pad; MH_0-80_Screw_Grounded
J1, J2: Conn_02x04_Odd_Even; Conn_2x4_0.05in
Q1, Q2: Q_Photo_NPN_EC; D_0603_1608Metric
R1, R2: 2k7 5%; R_0402_1005Metric
R3, R4: 100k 1%; R_0402_1005Metric
U1, U2: MCP9700AT-E_TT; SOT-23; MPN MCP9700AT-E/TT; Digi-Key_PN MCP9700AT-E/TTCT-ND

Connections:
+5V: J1.6, Q1.2 (C), Q2.2 (C), U1.1 (VDD), U2.1 (VDD)
GND: H1.1, H2.1, H3.1, H4.1, H6.1, H7.1, J2.5, R1.2, R2.2, R3.2, R4.2, U1.3 (GND), U2.3 (GND)
LED+: D5.1 (K), J2.1, J2.2, J2.3
LED-: D3.2 (A), J1.5, J1.7, J1.8
LED_Sign_1: D1.2 (A), J1.1
LED_Sign_2: D2.2 (A), J1.3
LightSense1: J1.4, Q1.1 (E), R3.1
LightSense2: J2.7, Q2.1 (E), R4.1
unnamed: D1.1 (K), R1.1
unnamed: D2.1 (K), R2.1
unnamed: D3.1 (K), D4.2 (A)
unnamed: D4.1 (K), D5.2 (A)
Temp1: J1.2, U1.2 (VOUT)
Temp2: J2.4, U2.2 (VOUT)

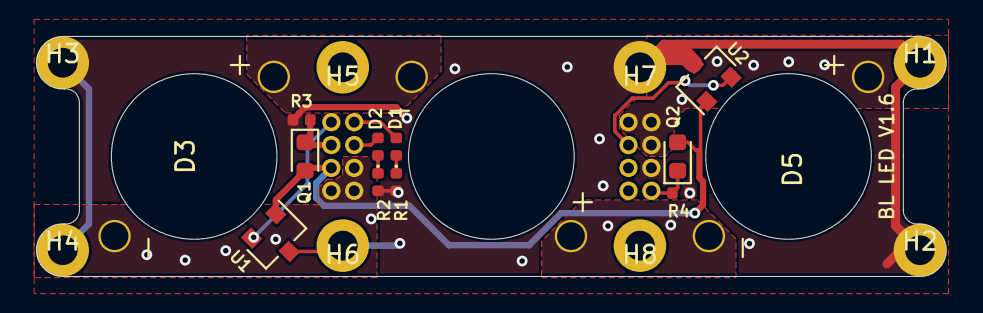
[picture p62: board Electrical/SkateLightLEDBoard/SkateLightLEDBoard1.6/SkateLightLEDBoar… from above]

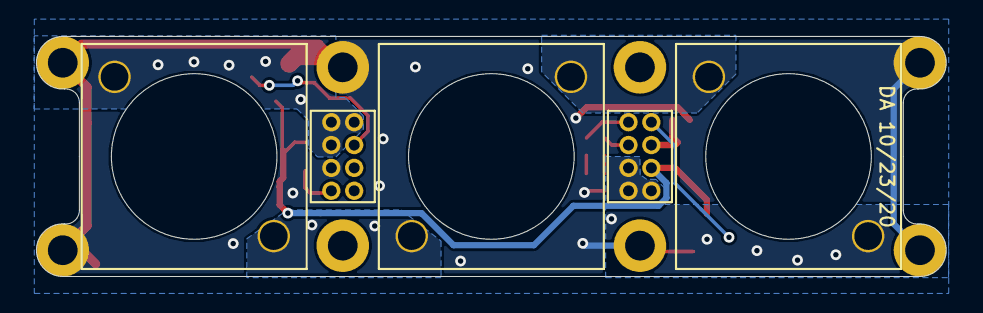
[picture p63: board Electrical/SkateLightLEDBoard/SkateLightLEDBoard1.6/SkateLightLEDBoar… from below]

Board: 2 copper layers, 50.5 x 13.3 mm, 23 parts (2 on the bottom side), 14 nets.
