dannyandreev/BOM-Lights/Electrical/SkateLightLEDBoard/SkateLightLEDBoard1.0/SkateLightLEDBoard.kicad_pcb

## KiCad design Electrical/SkateLightLEDBoard/SkateLightLEDBoard1.0/SkateLightLEDBoard.kicad_pcb (2022-03-13)

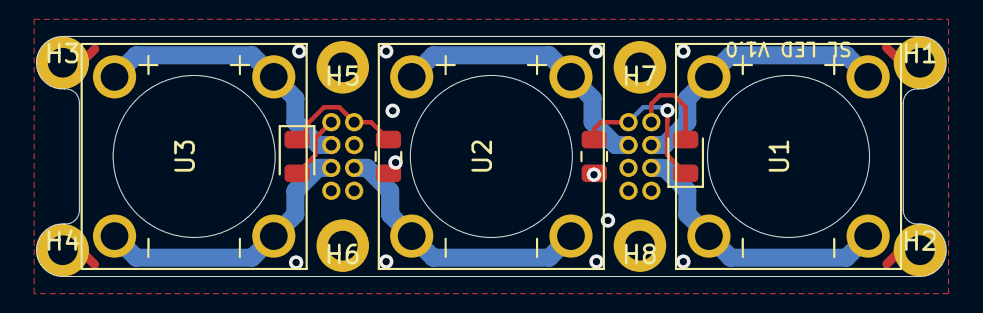
[picture p64: board Electrical/SkateLightLEDBoard/SkateLightLEDBoard1.0/SkateLightLEDBoar… from above]

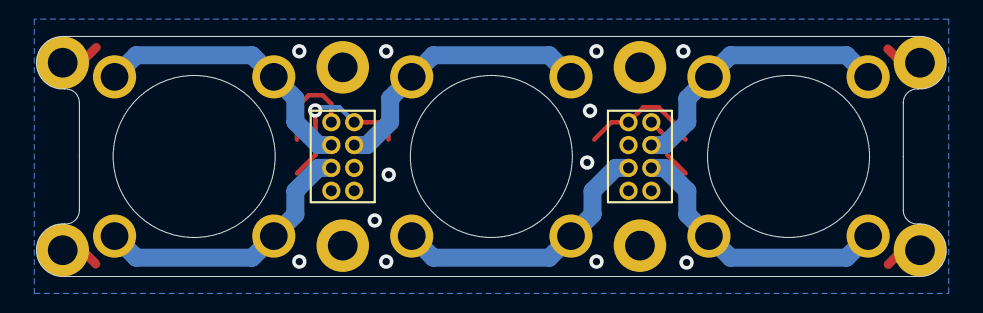
[picture p65: board Electrical/SkateLightLEDBoard/SkateLightLEDBoard1.0/SkateLightLEDBoar… from below]

Board: 2 copper layers, 50.5 x 13.3 mm, 17 parts (2 on the bottom side), 11 nets.

Parts:
D1, D2: D_Photo; D_0805_2012Metric
H1, H2, H3, H4, H5, H6, H7, H8: MountingHole_Pad; MH_0-80_Screw_Grounded
J1, J2: Conn_02x04_Odd_Even; Conn_2x4_0.05in
R1, R2: R; R_0805_2012Metric
U1, U2, U3: LED_4PinPackage; BXRE-40E0800-D-73

Connections:
3V3_1: D1.2, J1.1
3V3_2: D2.2, J2.2
GND: H1.1, H2.1, H3.1, H4.1, H5.1, H6.1, H7.1, H8.1, J1.8, J2.8, R1.2, R2.2
LED1A: J1.3, U1.1, U1.2
LED1C: J1.5, U1.3, U1.4
LED2A: J1.4, U2.1, U2.2
LED2C: J2.5, U2.3, U2.4
LED3A: J2.4, U3.1, U3.2
LED3C: J2.6, U3.3, U3.4
LightSense1: D1.1, J1.2, R1.1
LightSense2: D2.1, J2.1, R2.1
