dannyandreev/BOM-Lights/Electrical/SkateLightLEDBoard/SkateLightLEDBoard1.1/SkateLightLEDBoard.kicad_pcb

## KiCad design Electrical/SkateLightLEDBoard/SkateLightLEDBoard1.1/SkateLightLEDBoard.kicad_pcb (2022-03-13)

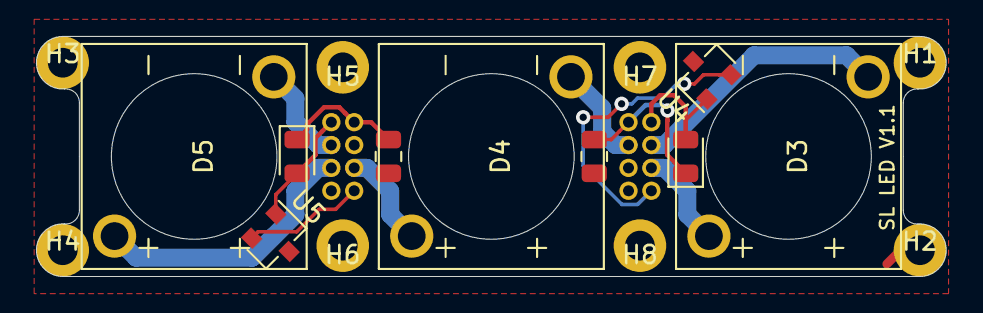
[picture p68: board Electrical/SkateLightLEDBoard/SkateLightLEDBoard1.1/SkateLightLEDBoar… from above]

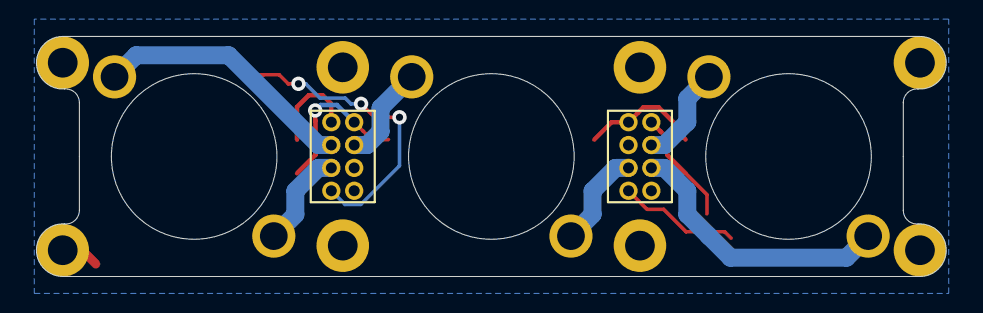
[picture p69: board Electrical/SkateLightLEDBoard/SkateLightLEDBoard1.1/SkateLightLEDBoar… from below]

Board: 2 copper layers, 50.5 x 13.3 mm, 19 parts (2 on the bottom side), 13 nets.

Parts:
D1, D2: D_Photo; D_0805_2012Metric
D3, D4, D5: LED; BXRE-40E0800-D-73
H1, H2, H3, H4, H5, H6, H7, H8: MountingHole_Pad; MH_0-80_Screw_Grounded
J1, J2: Conn_02x04_Odd_Even; Conn_2x4_0.05in
R1, R2: R; R_0805_2012Metric
U4, U5: MCP9700AT-E_TT; SOT-23

Connections:
3V3_1: D1.2, J1.1, U4.1
3V3_2: D2.2, J2.2, U5.1
GND: H1.1, H2.1, H3.1, H4.1, H5.1, H6.1, H7.1, H8.1, J1.8, J2.8, R1.2, R2.2, U4.3, U5.3
LED1A: D3.2, J1.3
LED1C: D3.1, J1.5
LED2A: D4.2, J1.4
LED2C: D4.1, J2.5
LED3A: D5.2, J2.4
LED3C: D5.1, J2.6
LightSense1: D1.1, J1.2, R1.1
LightSense2: D2.1, J2.1, R2.1
Temp1: J1.7, U4.2
Temp2: J2.7, U5.2
