dannyandreev/BOM-Lights/Electrical/SkateLightConnBoard/SkateLightConnBoard1.2/SkateLightConnBoard.kicad_pcb

## KiCad design Electrical/SkateLightConnBoard/SkateLightConnBoard1.2/SkateLightConnBoard.kicad_pcb (2022-03-13)

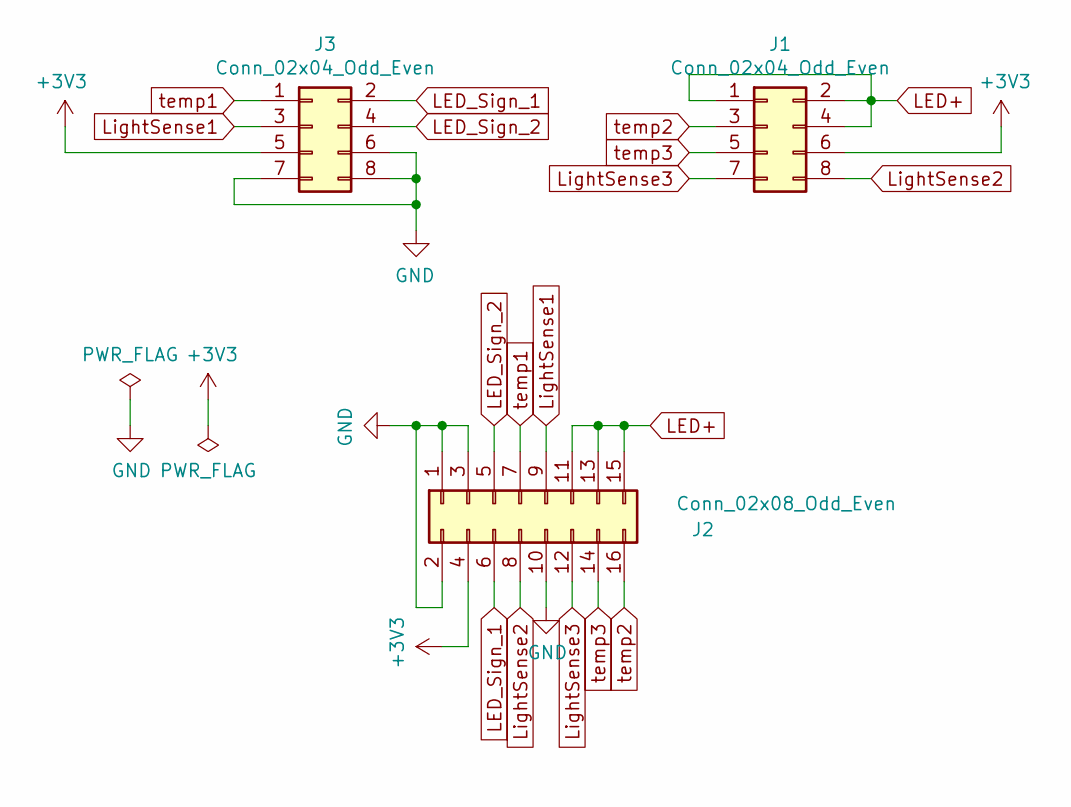
[picture p70: schematic SkateLightConnBoard.sch]

Parts:
J1, J3: Conn_02x04_Odd_Even; Conn_2x4_0.05in
J2: Conn_02x08_Odd_Even; Conn_2x8_0.05in

Connections:
+3V3: J1.6, J2.4, J3.5
GND: J2.1, J2.2, J2.3, J2.10, J3.6, J3.7, J3.8
LED+: J1.1, J1.2, J1.4, J2.11, J2.13, J2.15
LED_Sign_1: J2.6, J3.2
LED_Sign_2: J2.5, J3.4
LightSense1: J2.9, J3.3
LightSense2: J1.8, J2.8
LightSense3: J1.7, J2.12
temp1: J2.7, J3.1
temp2: J1.3, J2.16
temp3: J1.5, J2.14

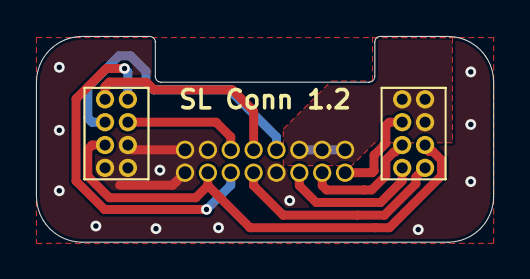
[picture p71: board Electrical/SkateLightConnBoard/SkateLightConnBoard1.2/SkateLightConnB… from above]

Board: 2 copper layers, 25.4 x 11.4 mm, 3 parts (1 on the bottom side), 11 nets.
